hegazyy11/MCT231_Final_Project/Docs/AMONG US BASICS PRESENT FINAL.pptx

AIN SHAMS UNIVERSITY · MECHATRONICS ENGINEERING

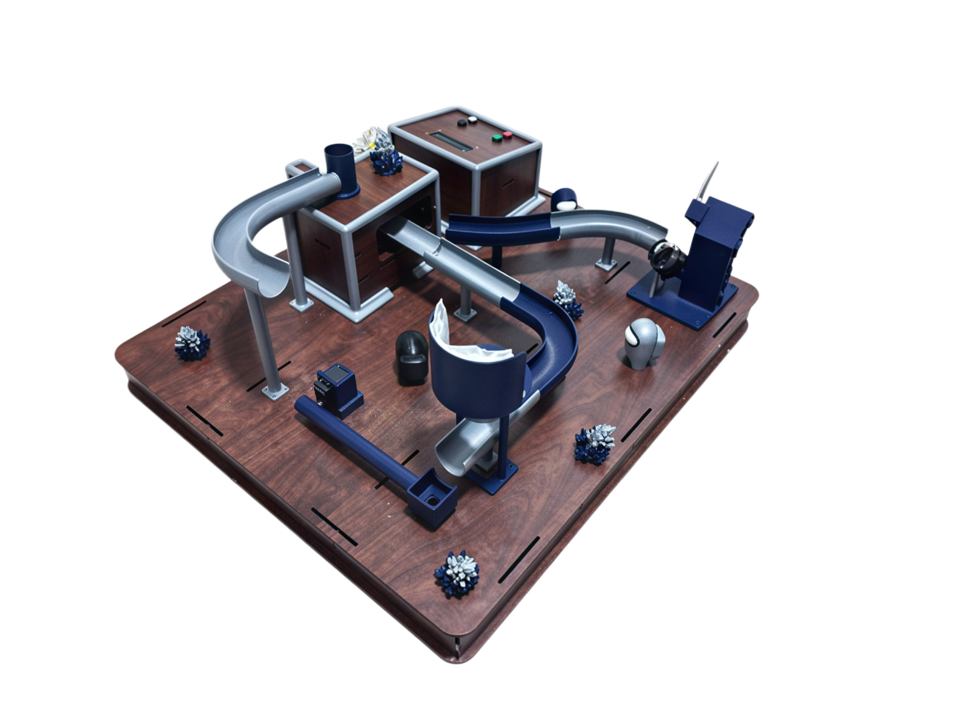
[picture p3: figure]

AMONG US

An automated closed-loop sorting, shooting & lifting toy

MCT231 — Basics of Mechatronics

Academic Year 2025 / 2026

Supervisor: Dr. Shady A. Maged

TEAM · Omar · Anas · Teefa · Essa · Mario

AMONG US

MCT231

01

## Slide 2

01 · CONTENTS

Agenda

Concept & Game

Theme, story, play loop

System Overview

The closed-loop flow

Design & Build

CAD and real prototype

Mechanisms

Sorting · Shooting · Lifting

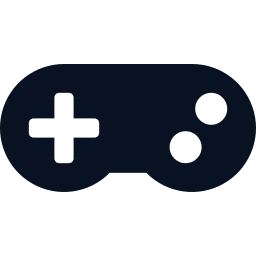
[picture p4: figure]
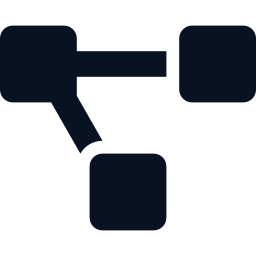
[picture p5: figure]
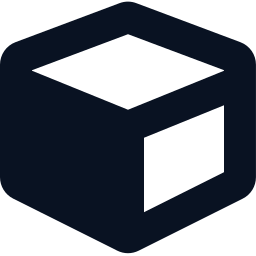
[picture p6: figure]
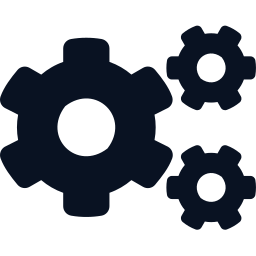
[picture p7: figure]

Electronics

Power, control & comms

Application

App & Bluetooth link

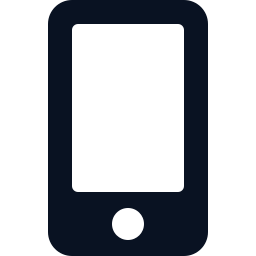
[picture p8: figure]

Problems Solved

Iteration & safety

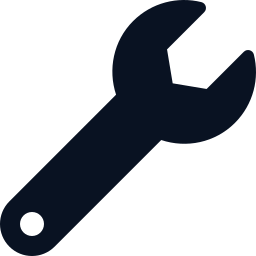
[picture p9: figure]

Results

Validation & outcomes

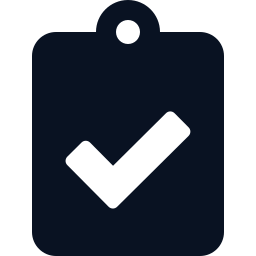
[picture p10: figure]

AMONG US

MCT231

01

## Slide 3

02 · OVERVIEW

Project Overview

An electromechanical toy for children aged 2–10 that demonstrates an automated sort–transport–dispatch cycle as a continuous physical closed loop, with a companion app for play.

KEY SPECIFICATIONS

HC-05 Bluetooth

Controllers

Inter-MCU link

Mega 2560 + Uno R3

UART · 9600 baud

Three mechanisms

Colour sorting, projectile shooting, vertical lifting.

Interfaces

I2C LCD + Processing app

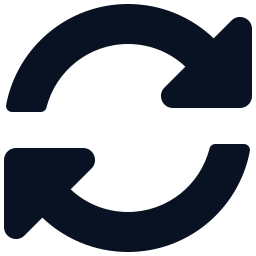
[picture p11: figure]

Closed loop

Single marble inlet; no manual reloading during play.

Wireless

Power

Single SMPS 220 V→12 V

Game

120 s timer · lives · penalties

Two microcontrollers

Arduino Mega (master) + Uno (slave) over UART.

AMONG US

MCT231

02

## Slide 4

03 · CONCEPT

Theme & Story

Reactor defusal

Inspired by the cooperative game Among Us, the player stabilises a sabotaged lunar reactor by filtering pure fuel cells (white & black balls) from corrupted ones before the countdown expires. A correct cell advances the sequence; a wrong cell costs a life and adds a time penalty.

VISUAL IDENTITY

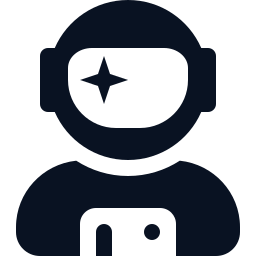
[picture p12: figure]

Navy

Lunar grey

Cyan

Red

AMONG US

MCT231

03

## Slide 5

04 · GAMEPLAY

How It Plays

Generate

App creates a colour code & starts a 120 s timer

1

Input

Player enters the code on the control panel

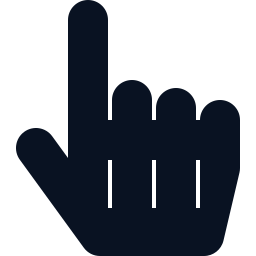
[picture p13: figure]

2

Sort

IR sensor reads each ball at the inlet

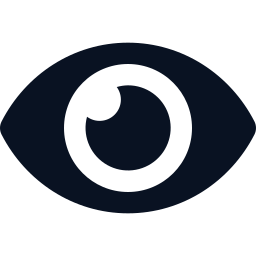
[picture p14: figure]

3

Act

Match → shoot; mismatch → reject & retry

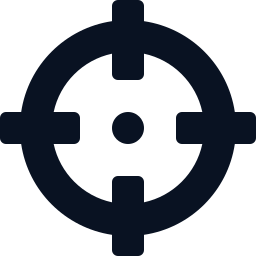
[picture p15: figure]

4

Loop

Lift returns every ball to the start

5

Correct sorting advances the defusal · incorrect sorting deducts a life + time penalty

AMONG US

MCT231

04

## Slide 6

05 · ARCHITECTURE

The Closed Loop

RE-ENTER LOOP — continuous, no manual reload

SORT

IR colour read

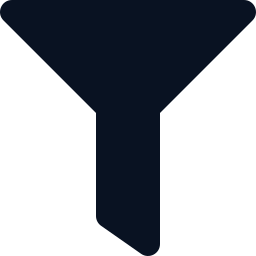
[picture p16: figure]

MATCH

SHOOT

DC motor fires
into funnel

LIFT

Servo returns
ball to start

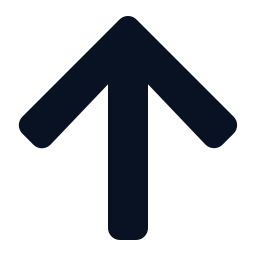
[picture p17: figure]

MISMATCH

RETURN PATH · bypasses shooter

AMONG US

MCT231

05

## Slide 7

06 · DESIGN

CAD Design

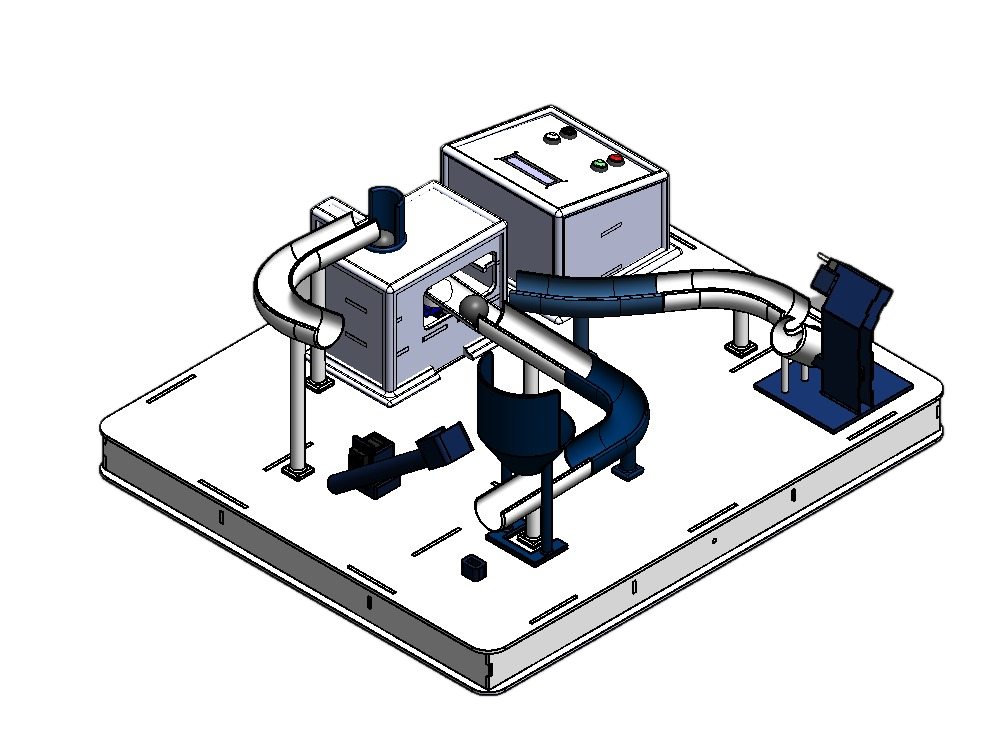
[picture p18: figure]

Fully integrated assembly

Designed in CAD; laser-cut MDF chassis with 3D-printed marble tracks and funnels.

AMONG US

MCT231

06

## Slide 8

07 · DESIGN

The Real Prototype

AMONG US

MCT231

07

## Slide 9

08 · MECHANISMS

Sorting Mechanism

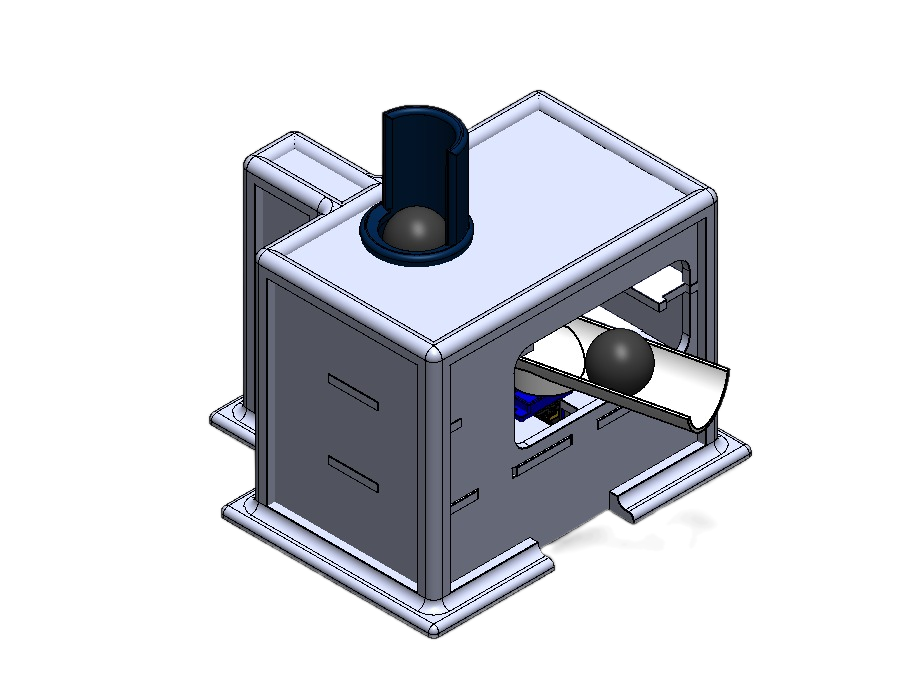
[picture p19: figure]

Entry point of the loop. A presence IR detects the ball; the colour IR reads white vs black; servos route and release the ball.

Holder servo

Home 180° → Reach 90°

Path servo

Home 105° / Shooter 142° / Return 97°

Colour sensor

Emitter power-gated per read

AMONG US

MCT231

08

## Slide 10

09 · MECHANISMS

Shooting Mechanism

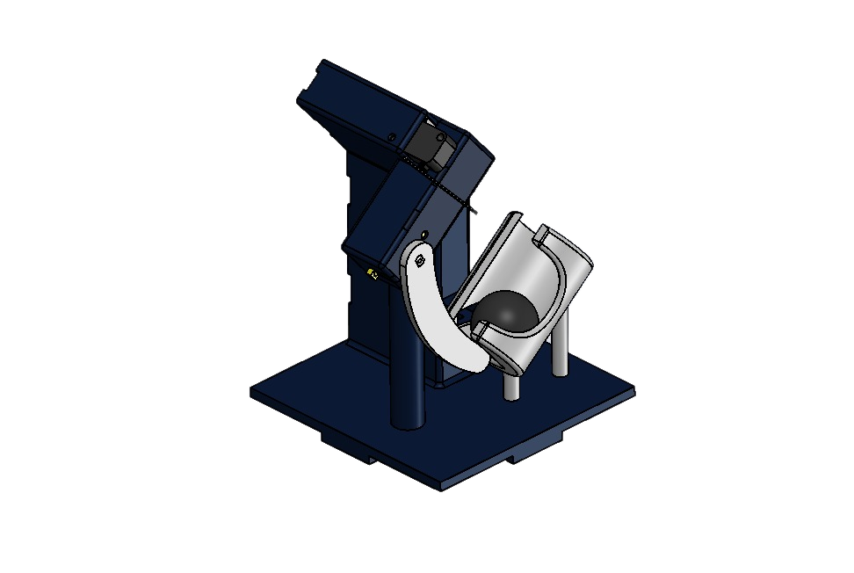
[picture p20: figure]

On a match the ball rolls to the barrel; a DC motor driven by an L298N fires it into the funnel, then retracts to a limit switch to re-home.

Driver

L298N H-bridge (PWM)

Fire / retract

PWM 90 / 35 of 255

Target range

≈ 30 cm @ 45° launch

AMONG US

MCT231

09

## Slide 11

10 · MECHANISMS

Lifting Mechanism

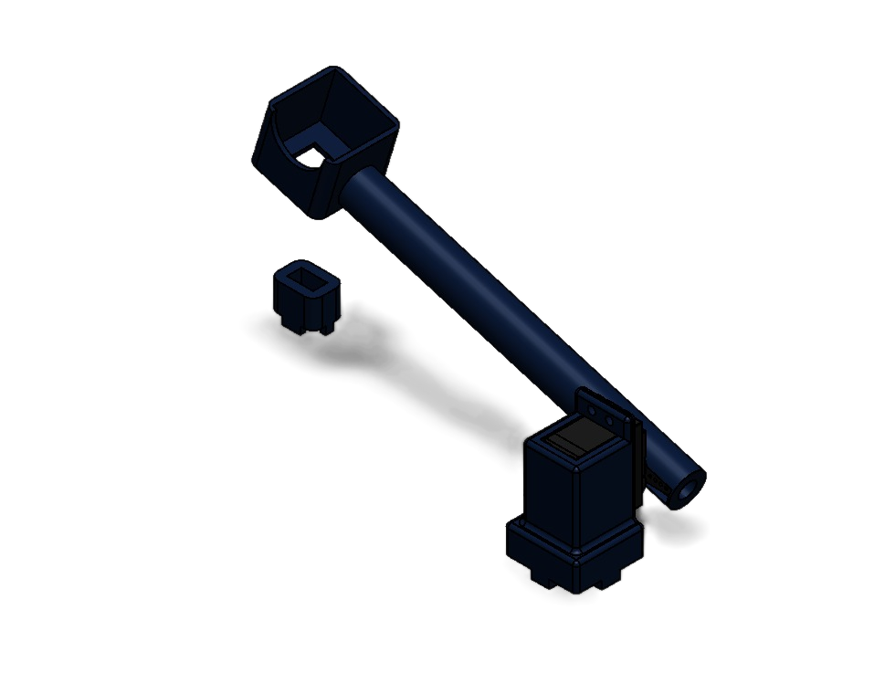
[picture p21: figure]

Common return stage for both branches. A lift IR detects the ball; the lift servo raises it and returns it to the sorting stage, closing the loop.

Lift servo

Rest 0° → Lift 95°

Detection

IR at elevator base

Role

Guarantees every ball re-enters

AMONG US

MCT231

10

## Slide 12

11 · ELECTRONICS

Power Architecture

Single source · common ground · hidden wiring

12 V BUS

SMPS

220 V AC → 12 V DC

L298N → DC motor

Shooter at 12 V

Buck converter → servos

Stepped-down servo rail

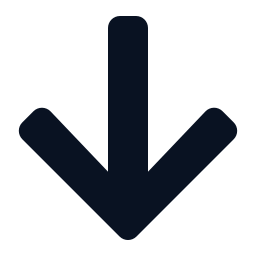
[picture p22: figure]

9 V regulator → Uno

Logic supply (VIN)

Two custom shield-PCBs (Uno + Mega) seat the boards on pin headers — no breadboards. Exceeds the ≥ 1 PCB requirement.

AMONG US

MCT231

11

## Slide 13

12 · ELECTRONICS

Control & Communication

Arduino Mega · MASTER

UI, game logic, verification & comms
LCD · 4 buttons · HC-05 · BT-state pin

MESSAGE PROTOCOL

Arduino Uno · SLAVE

Sensing & actuation
5× IR · 3× servo · L298N + DC motor · limit switch

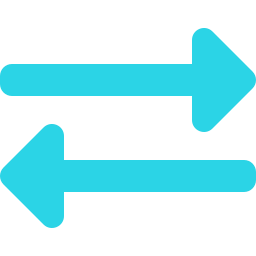
[picture p23: figure]

UART · 9600

Mega → Uno

“WBW…”

Player sequence

Built-in safety

Bluetooth-disconnect failsafe, remote app reset, and a reset routine that stops the motor, homes all servos, and clears the active sequence.

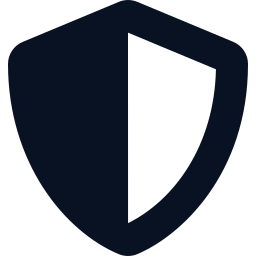
[picture p24: figure]

Mega → Uno

“R”

Reset

Uno → Mega

App → Mega

“D”

“W” / “B”

Tasks complete

Target code

Mega → App

“C” / “W”

Result

AMONG US

MCT231

12

## Slide 14

13 · INTERFACE

Mobile App & Bluetooth

App screens: code, countdown, lives, result

SCREENSHOT

Companion app

Generates the colour sequence, runs the 120 s countdown, tracks lives & penalties.

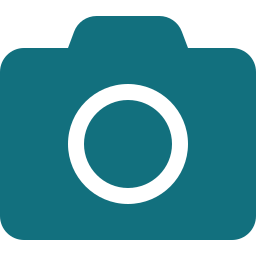
[picture p25: figure]

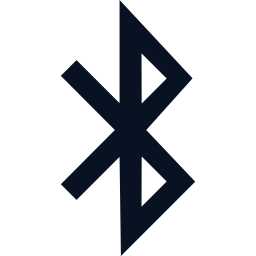
[picture p26: figure]

HC-05 link

Wireless serial pairing to the Mega for real-time, responsive control.

Second interface

Pairs with the on-board LCD to present two distinct information sets.

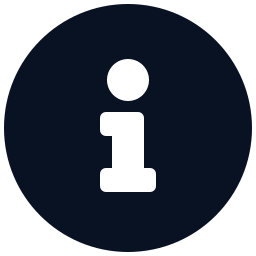
[picture p27: figure]

Status: simulation-tested — final HC-05 pairing & serial integration in progress

AMONG US

MCT231

13

## Slide 15

14 · ANALYSIS

Engineering Rigor

Every actuator is sized with the same chain: trapezoidal profile → inertia → phase torques → RMS → safety factor (1.5).

1.84

m/s launch speed

CORE FORMULAS

30

cm projectile range

1.5

safety factor (SF)

4.189

rad/s servo ωₘₐₓ

v = √(vₓ² + v_y²) v_y = √(2·g·ΔH) t_f = (v_y + √(v_y² + 2·g·y₀)) / g

J = ⅓·m·L² (rod) + m·L² (ball) T = J·α + g·(m·L/2 + m·L) T_rms = √(Σ Tᵢ²·tᵢ / t)

DC motor (L298N): I = T / K_t V = I·Rₐ + K_e·ω PWM = round((V/12)·255)

AMONG US

MCT231

14

## Slide 16

15 · ITERATION

Problem → Solution

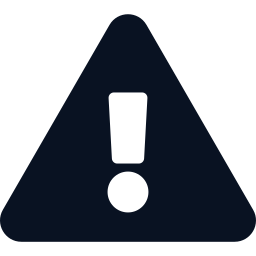
[picture p28: figure]

Sharp MDF edges

Laser-cut MDF leaves hard, sharp edges — unacceptable for a toy aimed at children aged 2–10.

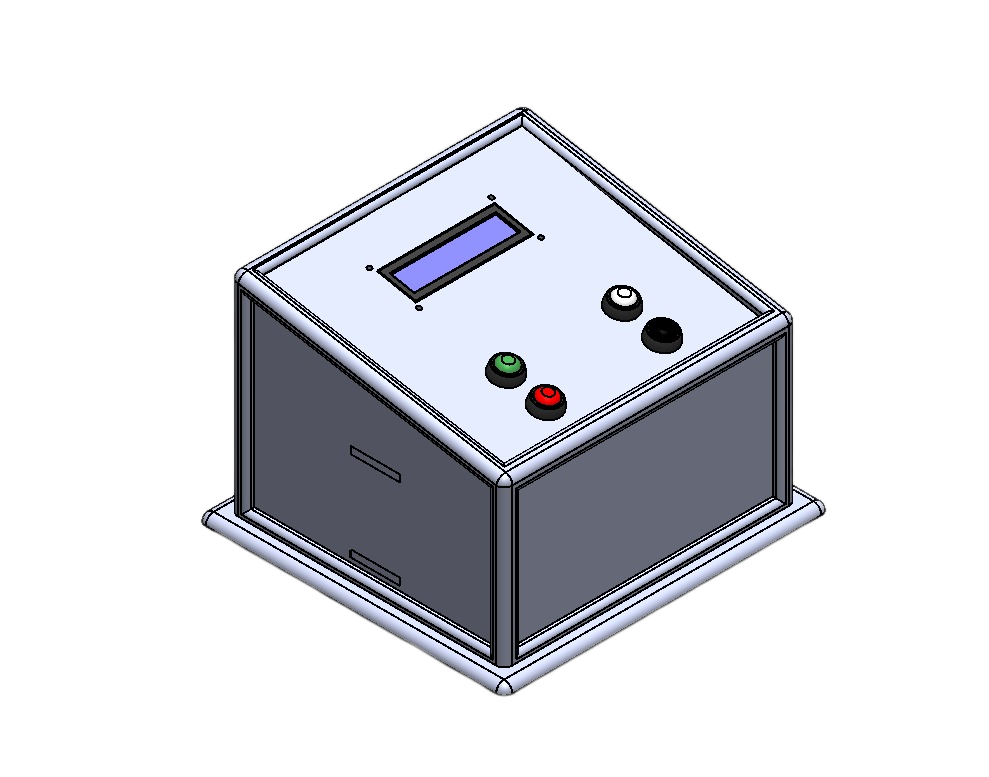
[picture p29: figure]

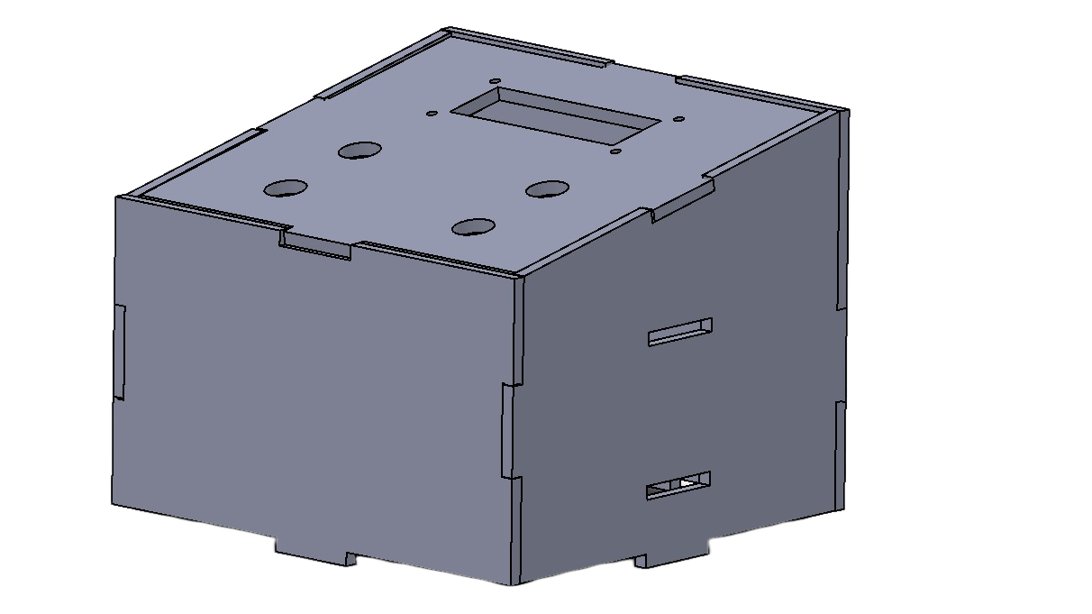
[picture p30: figure]

BEFORE

AFTER

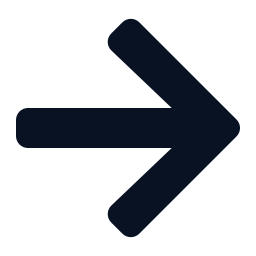
[picture p31: figure]

SOLUTION · 3D-printed edge covers on exposed edges only (not a full enclosure) — removes every reachable sharp edge while keeping the mechanisms visible.

AMONG US

MCT231

15

## Slide 17

16 · ITERATION

More Problems Solved

Exposed wiring

Loose jumper wires on the surface

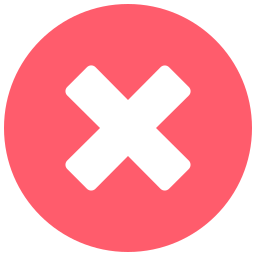
[picture p32: figure]
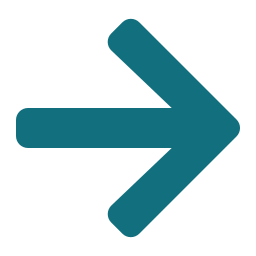
[picture p33: figure]
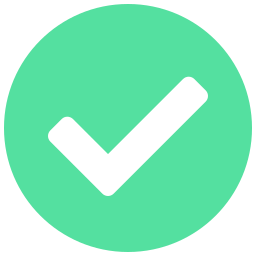
[picture p34: figure]

Routed below deck + shield-PCBs; nothing reachable

Unreliable colour read

Stray light skewed white/black detection

Power-gated emitter + calibrated threshold

AMONG US

MCT231

16

## Slide 18

17 · COMPLIANCE

Safety Considerations

No sharp edges

3D-printed covers on all exposed MDF edges

Hidden wiring

Harness below deck; no accessible contacts

Guarded motion

Moving parts shielded; choking review on balls

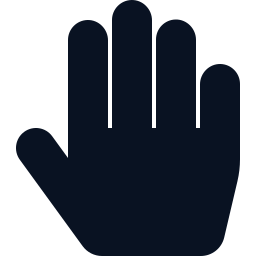
[picture p35: figure]

Single source

One SMPS, common ground, no exposed mains

Stop control

Physical start/stop + software reset

Standards intent

Aligned with CE / EN 71 toy safety

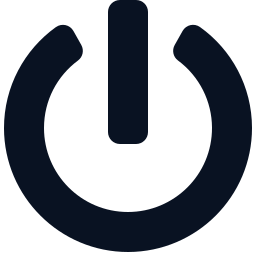
[picture p36: figure]

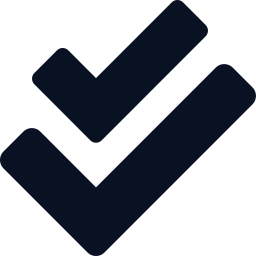
[picture p37: figure]

AMONG US

MCT231

17

## Slide 19

18 · EXECUTION

Project Management

TEAM & ROLES

Anas

CAD design

12-WEEK TIMELINE

Documentation

A

Omar

Coding + CAD design

Mechanical / CAD

O

Firmware

T

Teefa

App, comms & code integration

App / Bluetooth

E

Essa

PCB, wiring, PDS, block diagram

PCB / Electrical

M

Mario

Calculations + documentation

Integration

W1–W12 · critical path: CAD → Firmware → PCB → Integration

AMONG US

MCT231

18

## Slide 20

19 · OUTCOMES

Results & Assurance

≥ 95%

sorting accuracy target

< 200 ms

actuator response

50+

closed-loop cycles, no jam

0

dropped UART messages

VALIDATION · meets the goal

- Correct cells advance; wrong cells rejected
- App, LCD, lives & timer mirror the machine
- Safe & engaging for ages 2–10

VERIFICATION · meets the spec

- Servo set-points hit; PWM fire/retract verified
- UART 9600 baud, zero dropped messages
- Edge covers inspected; rails < 5% droop

AMONG US

MCT231

19

## Slide 21

20 · HARDWARE

Core Components

Arduino Mega 2560

Master controller

Arduino Uno R3

Slave controller

HC-05

Bluetooth module

I2C 16×2 LCD

On-board display

Servo motors ×3

Holder / path / lift

DC motor + L298N

Projectile shooter

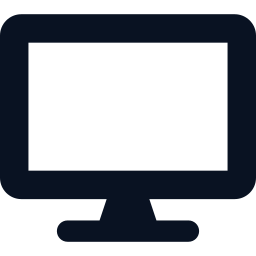
[picture p38: figure]

IR sensors ×5

Presence / colour / barrel / lift

SMPS + buck + 9 V reg

Power chain

2× shield-PCBs

Uno + Mega

AMONG US

MCT231

20

## Slide 22

21 · CLOSING

Conclusion & Next Steps

DELIVERED

- Working closed-loop toy: sort, shoot, lift
- Two-MCU master/slave over UART
- Two interfaces: LCD + Bluetooth app
- Two custom shield-PCBs, single SMPS
- Child-safe finish via 3D-printed edge covers

NEXT STEPS

Finish HC-05 pairing + serial in the app

Complete current-consumption measurements

Add sound effects & difficulty levels

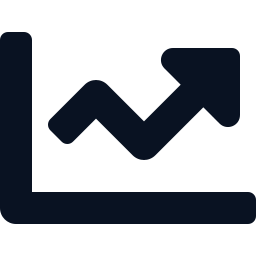
[picture p39: figure]

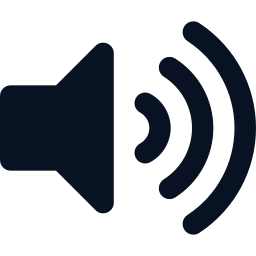
[picture p40: figure]

AMONG US

MCT231

21

## Slide 23

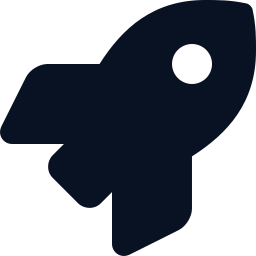
[picture p41: figure]

Thank You

Questions & discussion welcome

AMONG US · MCT231 · Omar · Anas · Teefa · Essa · Mario

AMONG US

MCT231

22
