hegazyy11/MCT231_Final_Project/Mechanical/Electric Box/Electric_Box.SLDASM

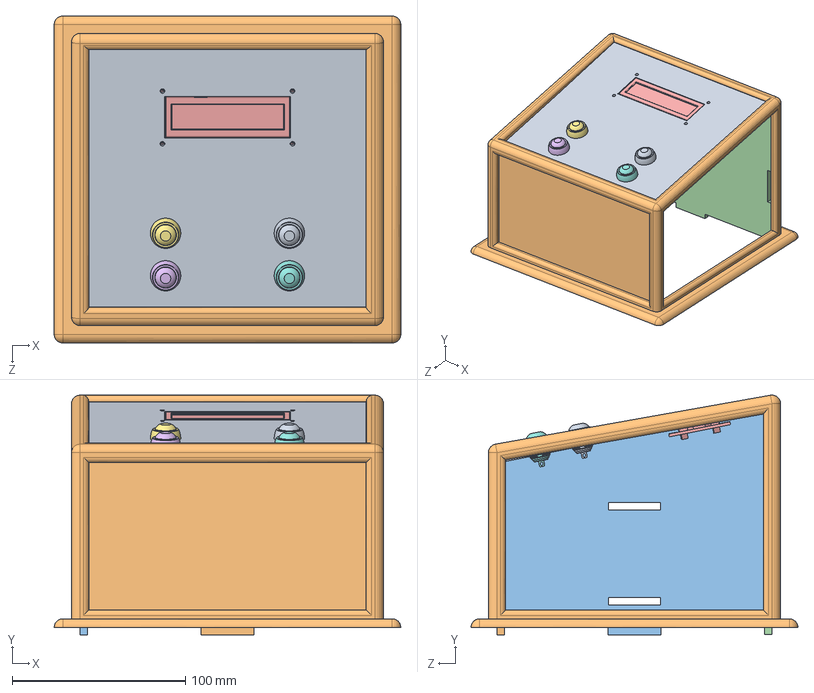
[picture p63: CAD file, 2026-06-11]
Mechanical/Electric Box/Electric_Box.SLDASM
200.0 x 138.3 x 188.6 mm
Elec_Back
Elec_Side
Elec_Front
Elec_Seiling
LCD_1602
ic184-thread_red
ic184-thread
ic184-thread_black
ic184-thread_white
box coverrrrrrr
