hegazyy11/MCT231_Final_Project/Mechanical/Project.SLDASM

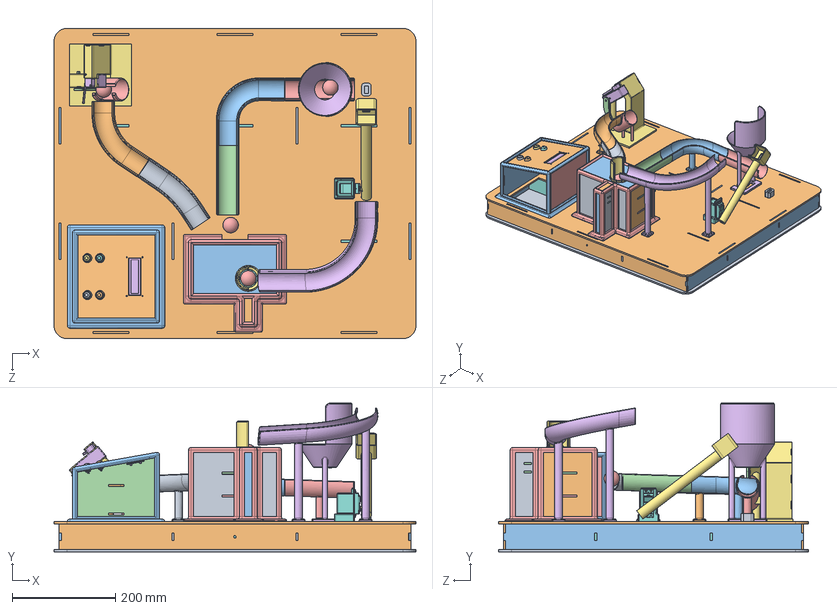
[picture p64: CAD file, 2026-06-11]
Mechanical/Project.SLDASM
700.0 x 287.9 x 600.0 mm
Short Side x 2
Long Side x 2
Middle Support (Short) x 2
Middle Support (Long) x 2
Motor Hub
Motor Hub Cover
tt motor
Shooting slide
Ball x 5
DC Arm
SWITCH LIMIT 30x16x10
Shooting wiring route cover
Upper Base
IR Hub
Motor Pillar2
Arm
attachmentStraight
servoMotorMG996R
Shooting_To_Lifting_Cone
Sorting_To_Lifting_Slide_3
Sorting_To_Lifting_Slide_1
Sorting_To_Lifting_Slide_2
Sorting_To_Shooting_Slide_2
Sorting_To_Shooting_Slide_1
Back Wall
Left Wall
Seiling
Second Floor
Upper Curve
First Floor
[4145] TowerPro SG90 Mini Servo-SunRobotics_in-Pt3 x 2
[4145] TowerPro SG90 Mini Servo-SunRobotics_in-Pt1 x 2
Right Wall
IR Tower Side x 2
IR Tower Seiling
IR Tower Back
IR Floor x 2
Soring Cone 2
sorting covvvver
Lifting_To_Sorting_Slide
Elec_Back
Elec_Side
Elec_Front
Elec_Seiling
LCD_1602
ic184-thread_red
ic184-thread
ic184-thread_black
ic184-thread_white
box coverrrrrrr
Lower Base
sorting face
