hegazyy11/MCT231_Final_Project/Mechanical/Sorting Mechanism/Sorting Mechanism.SLDASM

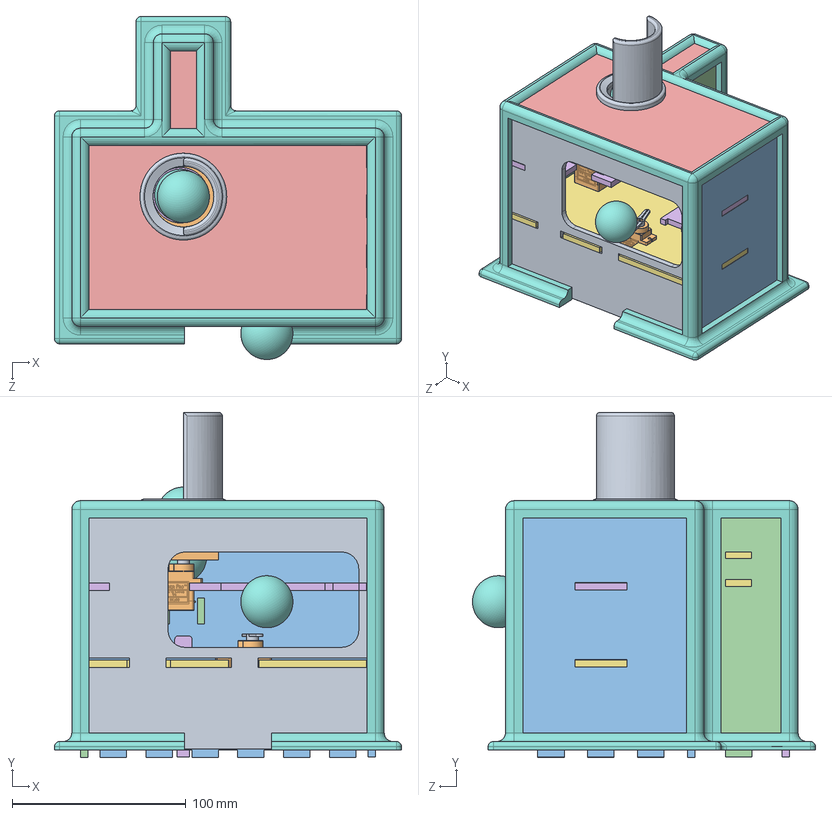
[picture p65: CAD file, 2026-06-11]
Mechanical/Sorting Mechanism/Sorting Mechanism.SLDASM
200.0 x 198.9 x 197.6 mm
Back Wall
Left Wall
Seiling
Second Floor
Upper Curve
First Floor
Ball x 3
[4145] TowerPro SG90 Mini Servo-SunRobotics_in-Pt3 x 2
[4145] TowerPro SG90 Mini Servo-SunRobotics_in-Pt1 x 2
Right Wall
IR Tower Side x 2
IR Tower Seiling
IR Tower Back
IR Floor x 2
Soring Cone 2
sorting face
