hegazyy11/MCT231_Final_Project/Mechanical/Shooting Mechanism/Motor Hub Assembly.SLDASM

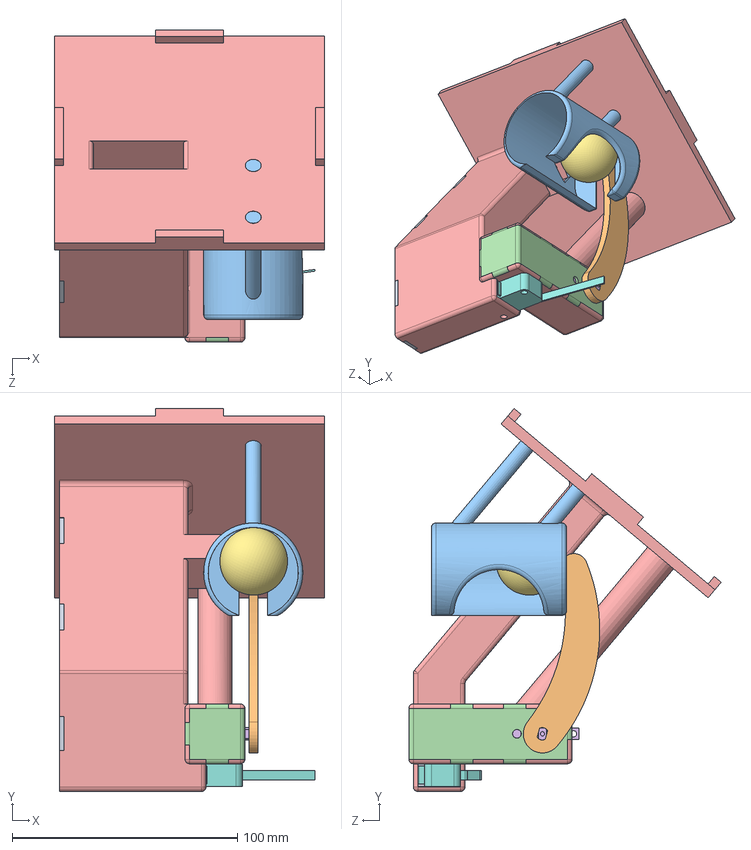
[picture p66: CAD file, 2026-06-11]
Mechanical/Shooting Mechanism/Motor Hub Assembly.SLDASM
120.0 x 170.0 x 138.7 mm
Motor Hub
Motor Hub Cover
tt motor
Shooting slide
Ball
DC Arm
SWITCH LIMIT 30x16x10
Shooting wiring route cover
