hegazyy11/MCT231_Final_Project/Mechanical/Base/Upper Base.SLDPRT

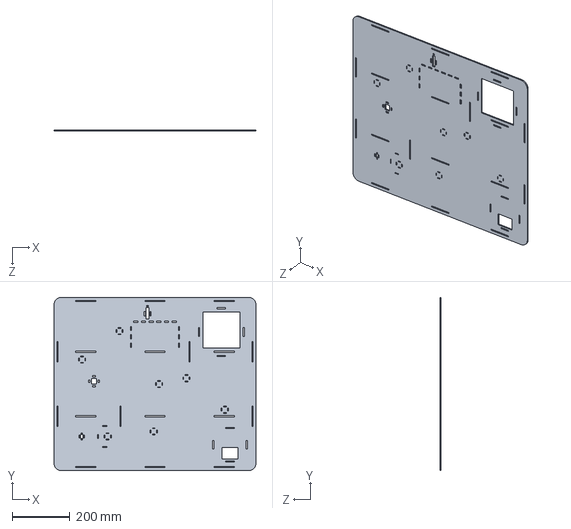
[picture p67: CAD file, 2026-06-11]
Mechanical/Base/Upper Base.SLDPRT
700.0 x 600.0 x 4.30 mm
