hegazyy11/MCT231_Final_Project/Mechanical/Lifting Mechansim/Arm.SLDPRT

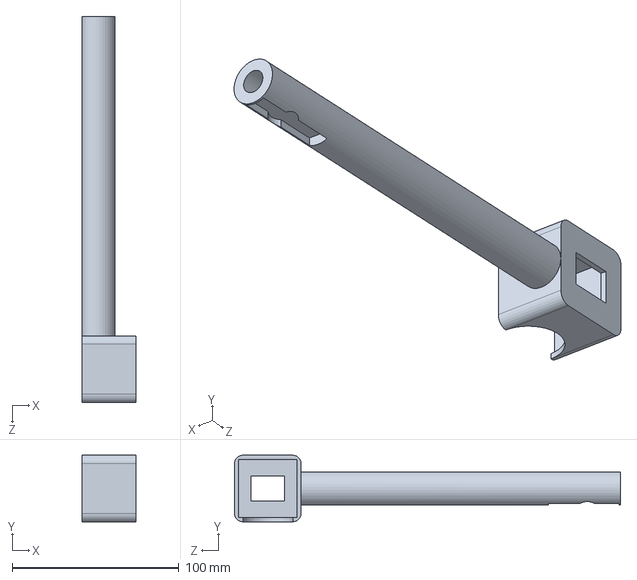
[picture p68: CAD file, 2026-06-11]
Mechanical/Lifting Mechansim/Arm.SLDPRT
32.5 x 40.0 x 231.7 mm
