hegazyy11/MCT231_Final_Project/Mechanical/Routing/Lifting_To_Sorting_Slide.SLDPRT

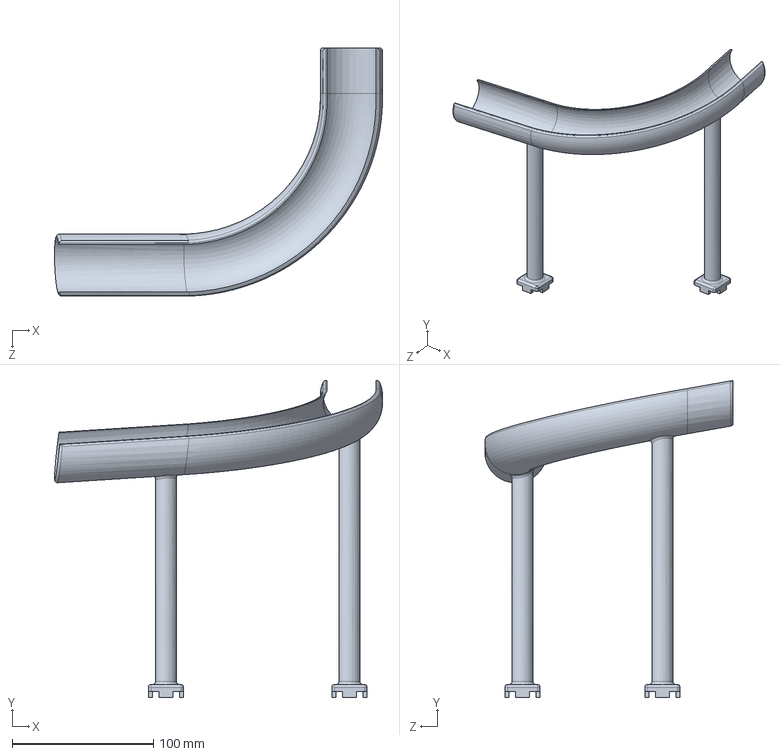
[picture p69: CAD file, 2026-06-11]
Mechanical/Routing/Lifting_To_Sorting_Slide.SLDPRT
232.0 x 224.3 x 175.6 mm
