hegazyy11/MCT231_Final_Project/Mechanical/Shooting Mechanism/Shooting wiring route cover.SLDPRT

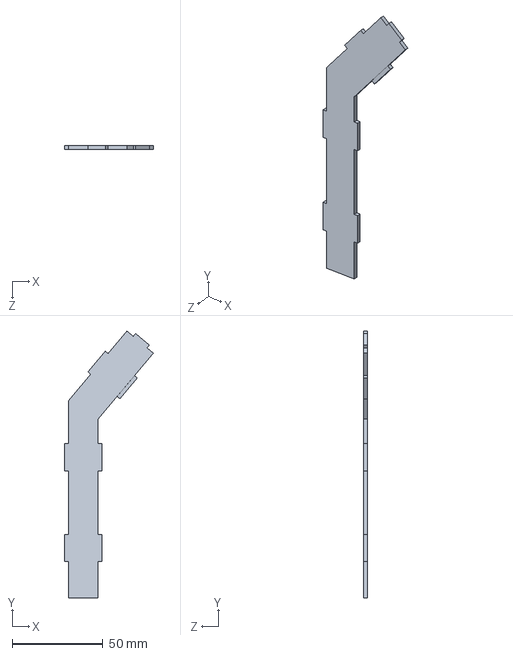
[picture p70: CAD file, 2026-06-11]
Mechanical/Shooting Mechanism/Shooting wiring route cover.SLDPRT
48.9 x 147.0 x 2.00 mm
