hegazyy11/MCT231_Final_Project/Mechanical/Sorting Mechanism/sorting face .SLDPRT

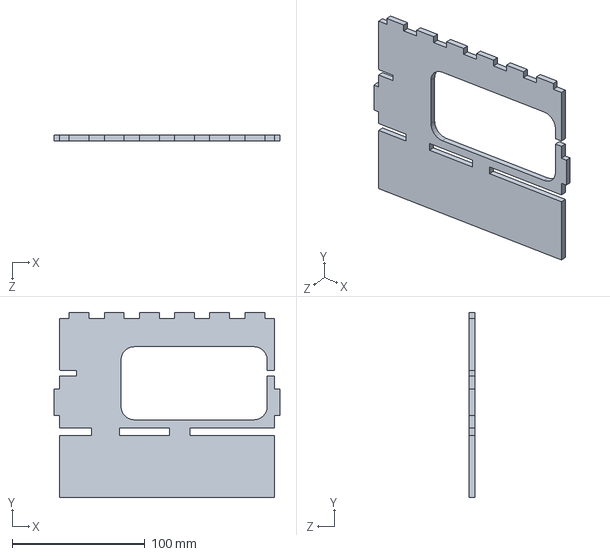
[picture p71: CAD file, 2026-06-11]
Mechanical/Sorting Mechanism/sorting face .SLDPRT
170.0 x 139.3 x 4.30 mm
