hegazyy11/MCT231_Final_Project/Mechanical/Base/Short Side.SLDPRT

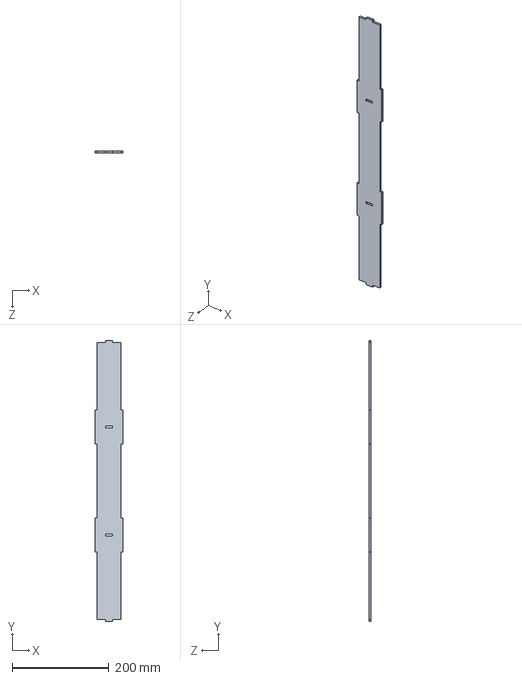
[picture p72: CAD file, 2026-06-11]
Mechanical/Base/Short Side.SLDPRT
58.6 x 580.6 x 4.30 mm
