hegazyy11/MCT231_Final_Project/Mechanical/Electric Box/LCD_1602.SLDPRT

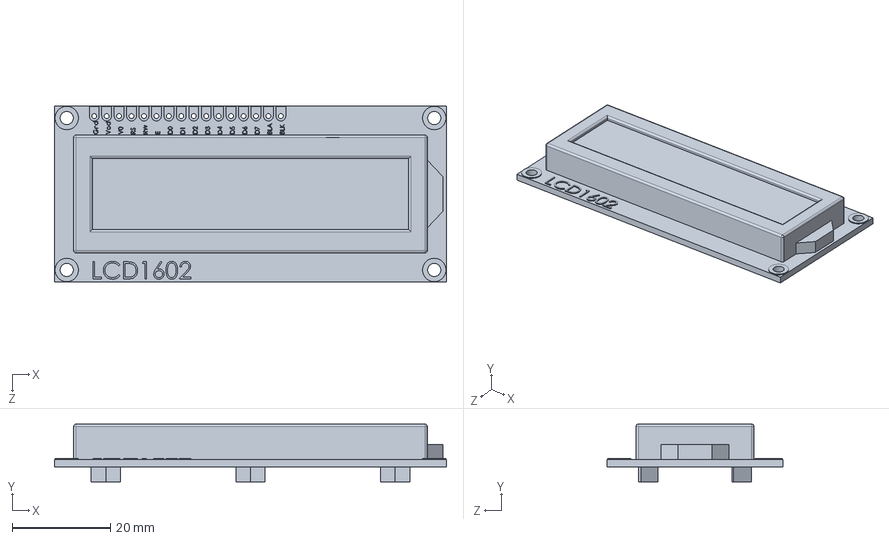
[picture p73: CAD file, 2026-06-11]
Mechanical/Electric Box/LCD_1602.SLDPRT
80.0 x 11.8 x 36.0 mm
