hegazyy11/MCT231_Final_Project/Mechanical/Lifting Mechansim/IR Hub.SLDPRT

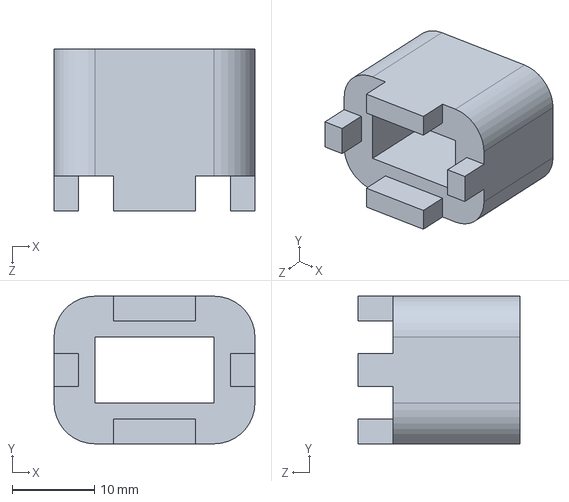
[picture p74: CAD file, 2026-06-11]
Mechanical/Lifting Mechansim/IR Hub.SLDPRT
24.5 x 18.0 x 19.8 mm
