hegazyy11/MCT231_Final_Project/Mechanical/Routing/Sorting_To_Shooting_Slide_2.SLDPRT

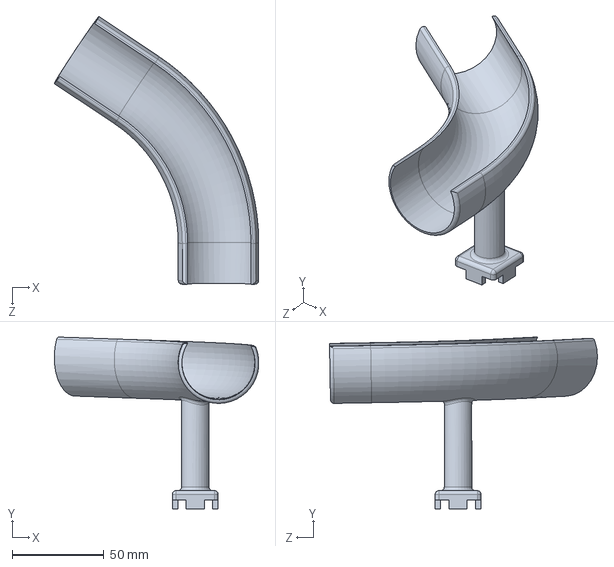
[picture p75: CAD file, 2026-06-11]
Mechanical/Routing/Sorting_To_Shooting_Slide_2.SLDPRT
111.6 x 93.8 x 146.3 mm
