hegazyy11/MCT231_Final_Project/Mechanical/Shooting Mechanism/Shooting slide.SLDPRT

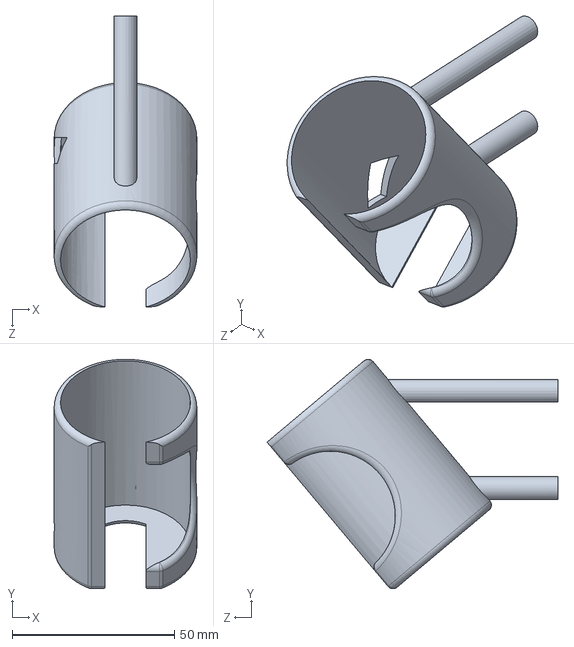
[picture p76: CAD file, 2026-06-11]
Mechanical/Shooting Mechanism/Shooting slide.SLDPRT
44.0 x 70.7 x 89.7 mm
