hegazyy11/MCT231_Final_Project/Mechanical/Base/Middle Support (Short).SLDPRT

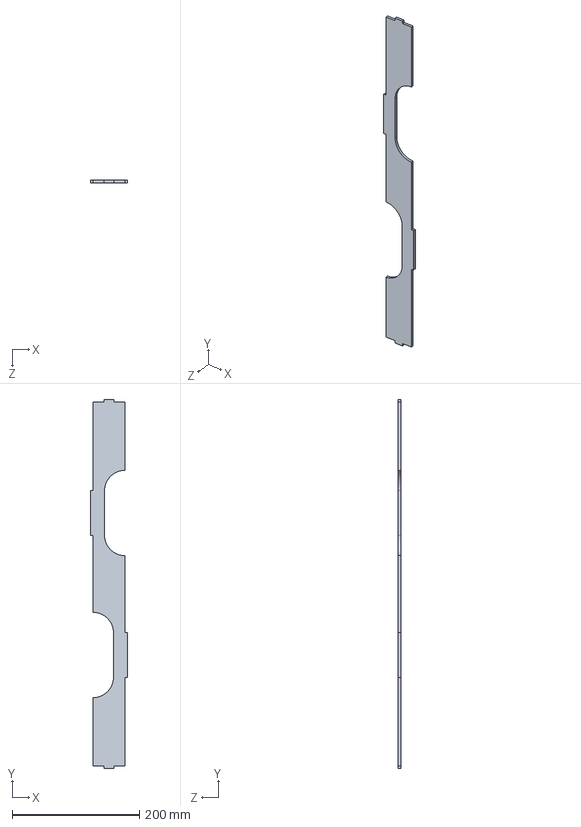
[picture p77: CAD file, 2026-06-11]
Mechanical/Base/Middle Support (Short).SLDPRT
58.6 x 580.6 x 4.30 mm
