hegazyy11/MCT231_Final_Project/Mechanical/Electric Box/ic184-thread_white.SLDPRT

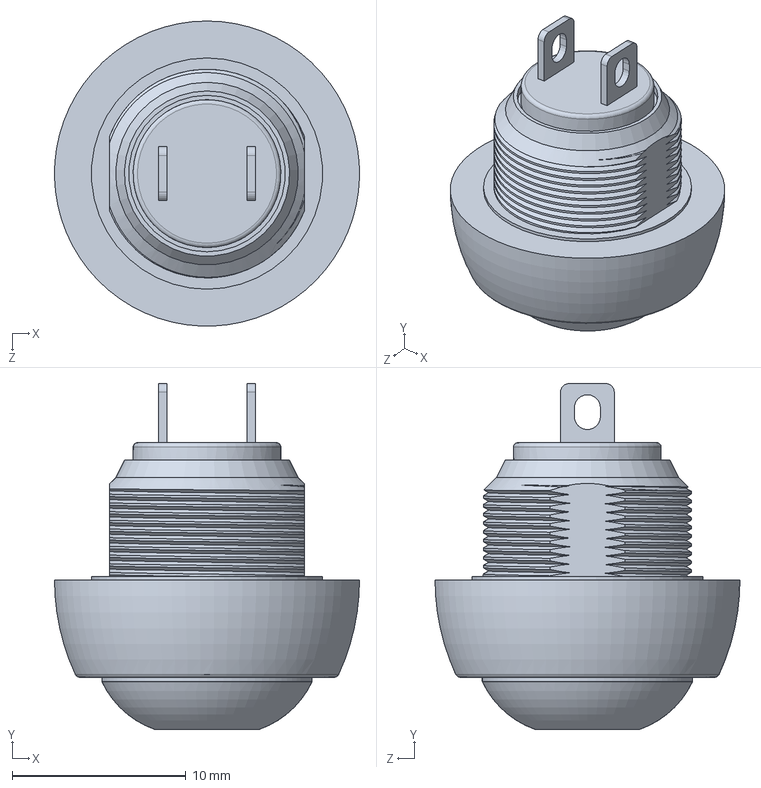
[picture p78: CAD file, 2026-06-11]
Mechanical/Electric Box/ic184-thread_white.SLDPRT
17.5 x 19.9 x 17.5 mm
