hegazyy11/MCT231_Final_Project/Mechanical/Lifting Mechansim/Motor Pillar2.SLDPRT

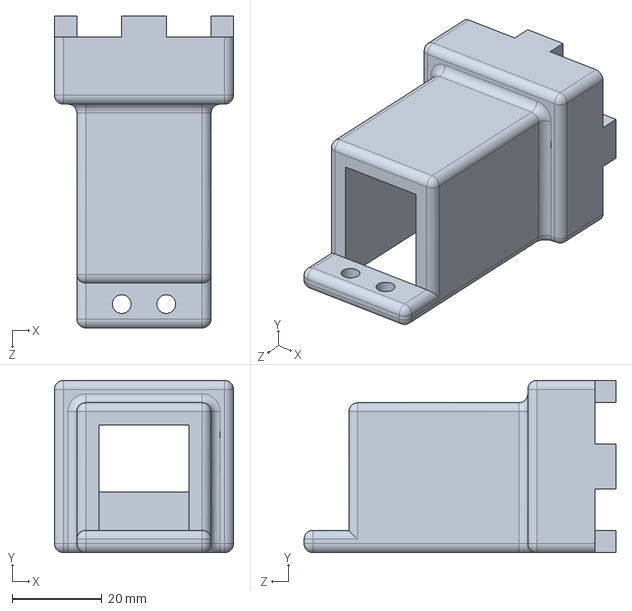
[picture p79: CAD file, 2026-06-11]
Mechanical/Lifting Mechansim/Motor Pillar2.SLDPRT
40.0 x 38.5 x 69.7 mm
