hegazyy11/MCT231_Final_Project/Mechanical/Routing/Sorting_To_Lifting_Slide_3.SLDPRT

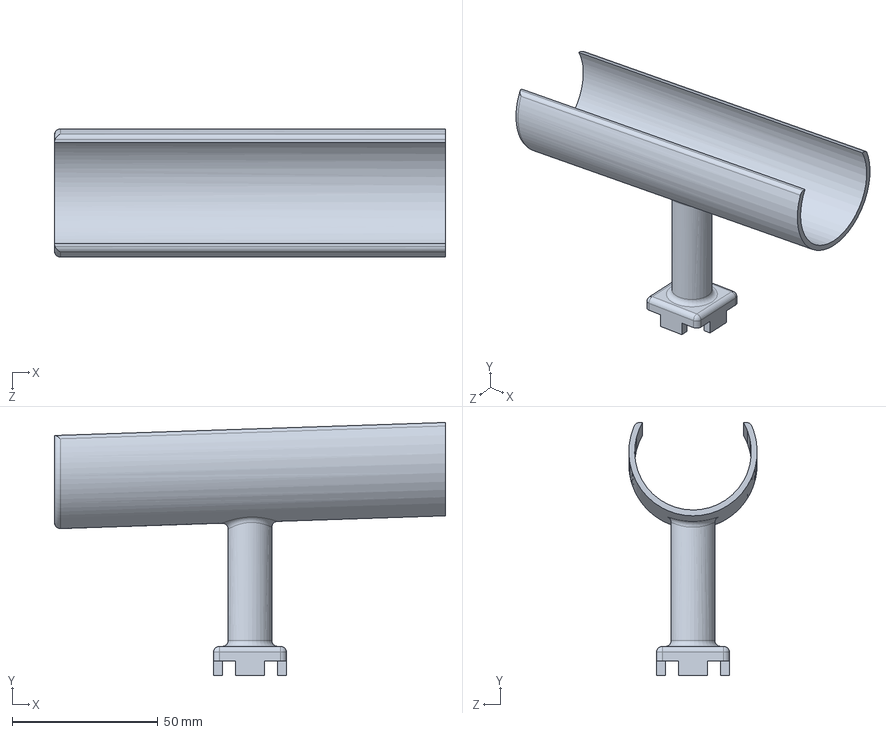
[picture p80: CAD file, 2026-06-11]
Mechanical/Routing/Sorting_To_Lifting_Slide_3.SLDPRT
134.0 x 86.7 x 44.0 mm
