hegazyy11/MCT231_Final_Project/Mechanical/Sorting Mechanism/[4145] TowerPro SG90 Mini Servo-SunRobotics_in-Pt1.SLDPRT

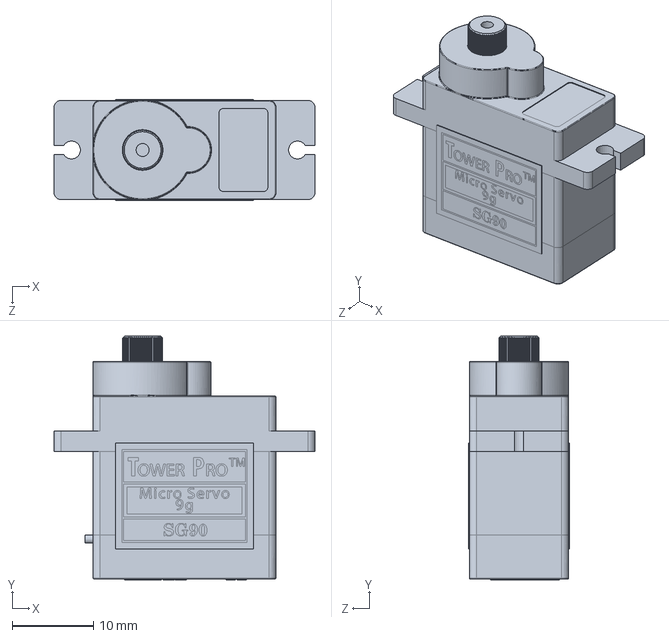
[picture p81: CAD file, 2026-06-11]
Mechanical/Sorting Mechanism/[4145] TowerPro SG90 Mini Servo-SunRobotics_in-Pt1.SLDPRT
32.1 x 30.0 x 12.4 mm
