hegazyy11/MCT231_Final_Project/Mechanical/Base/Long Side.SLDPRT

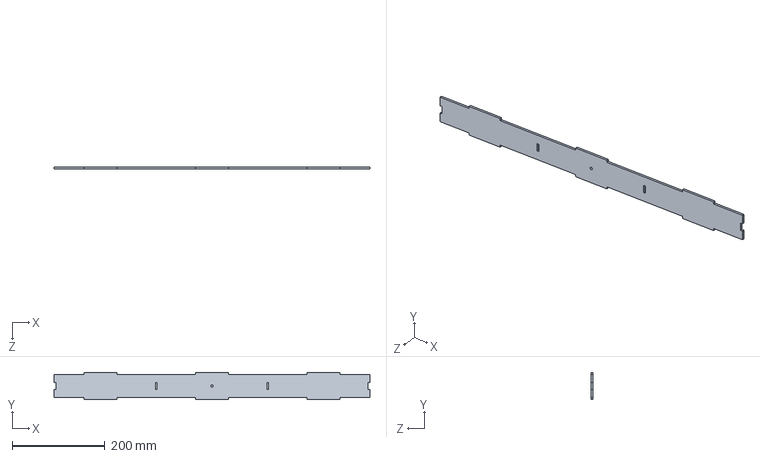
[picture p82: CAD file, 2026-06-11]
Mechanical/Base/Long Side.SLDPRT
680.0 x 58.6 x 4.30 mm
