hegazyy11/MCT231_Final_Project/Mechanical/Lifting Mechansim/servoMotorMG996R.SLDPRT

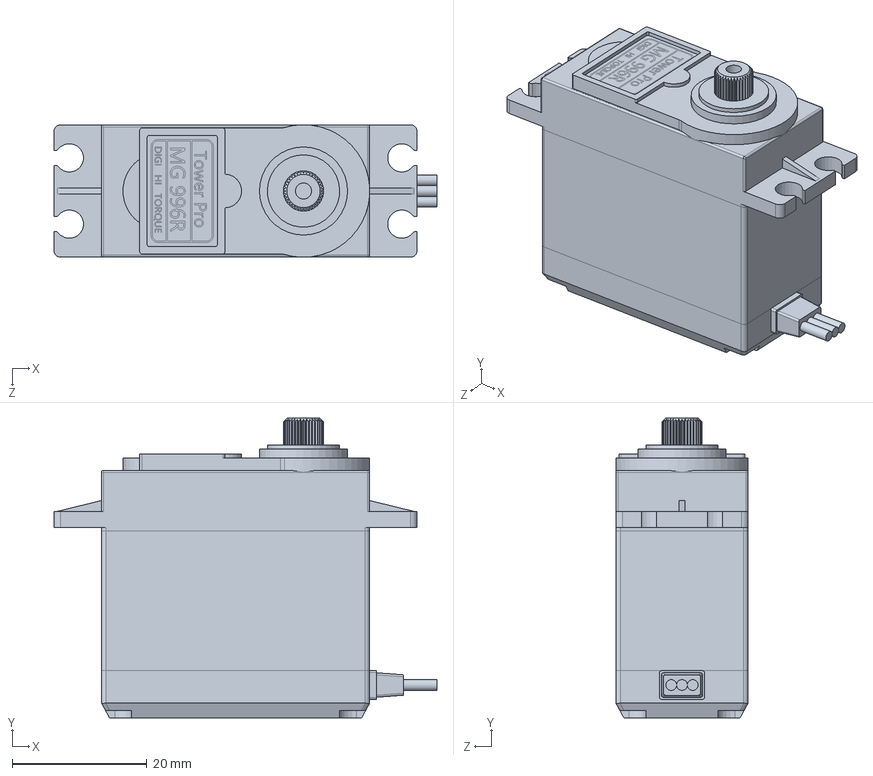
[picture p83: CAD file, 2026-06-11]
Mechanical/Lifting Mechansim/servoMotorMG996R.SLDPRT
57.0 x 44.5 x 19.7 mm
