hegazyy11/MCT231_Final_Project/Mechanical/Routing/Sorting_To_Lifting_Slide_2.SLDPRT

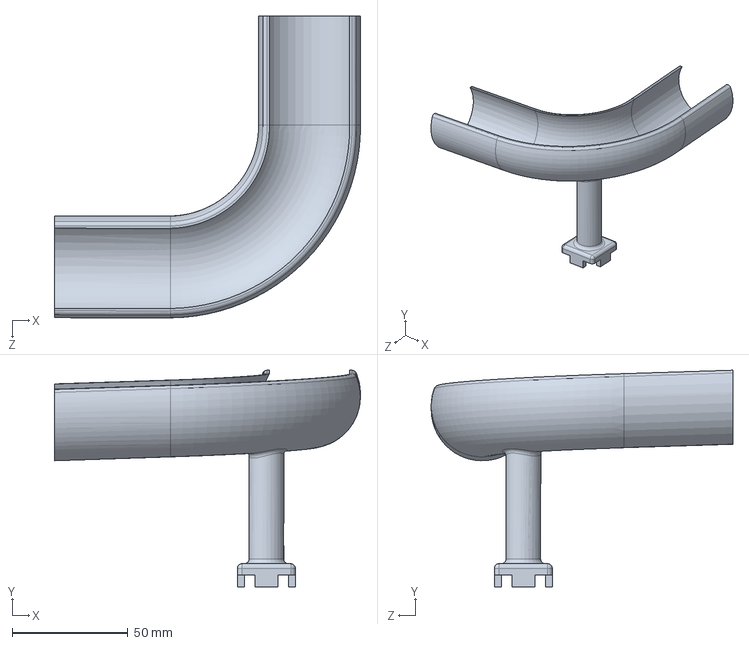
[picture p84: CAD file, 2026-06-11]
Mechanical/Routing/Sorting_To_Lifting_Slide_2.SLDPRT
132.0 x 93.4 x 130.2 mm
