hegazyy11/MCT231_Final_Project/Mechanical/Shooting Mechanism/Motor Hub Cover.SLDPRT

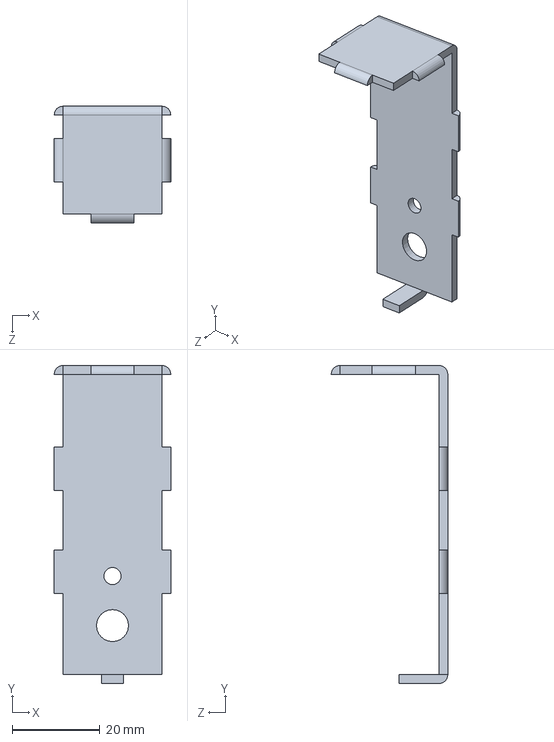
[picture p85: CAD file, 2026-06-11]
Mechanical/Shooting Mechanism/Motor Hub Cover.SLDPRT
26.6 x 72.5 x 26.6 mm
