hegazyy11/MCT231_Final_Project/Mechanical/Sorting Mechanism/Upper Curve.SLDPRT

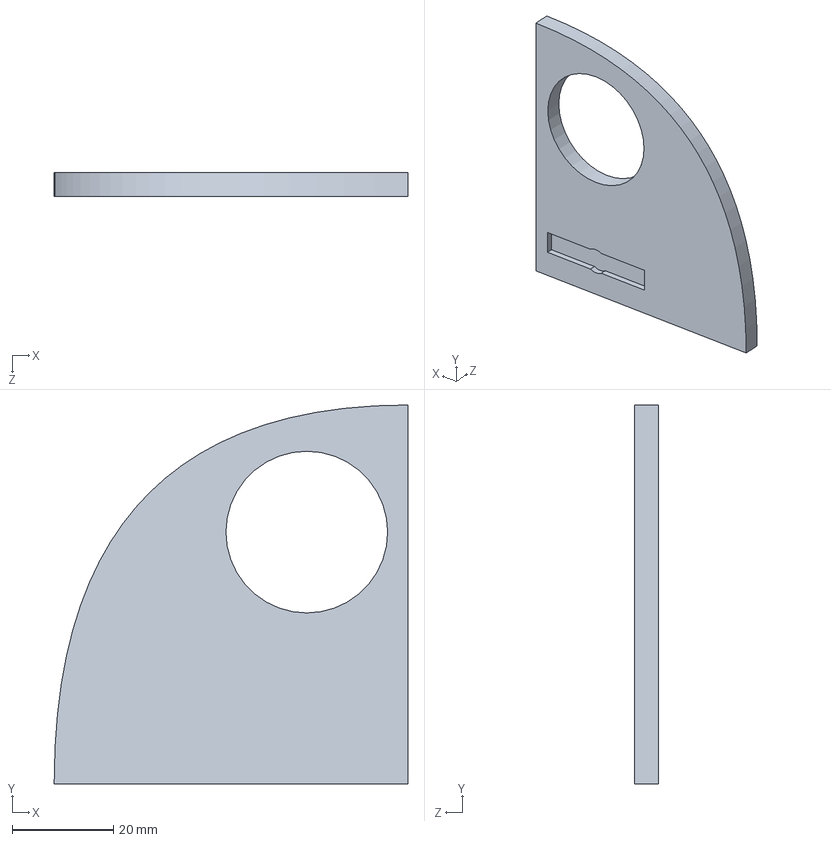
[picture p86: CAD file, 2026-06-11]
Mechanical/Sorting Mechanism/Upper Curve.SLDPRT
70.0 x 75.0 x 4.70 mm
