hegazyy11/MCT231_Final_Project/Mechanical/Base/Middle Support (Long).SLDPRT

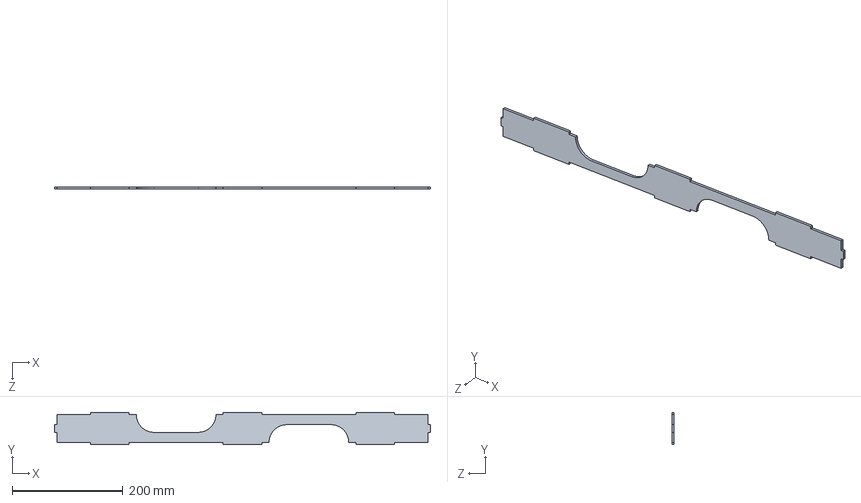
[picture p87: CAD file, 2026-06-11]
Mechanical/Base/Middle Support (Long).SLDPRT
680.0 x 58.6 x 4.30 mm
