hegazyy11/MCT231_Final_Project/Mechanical/Electric Box/Elec_Seiling.SLDPRT

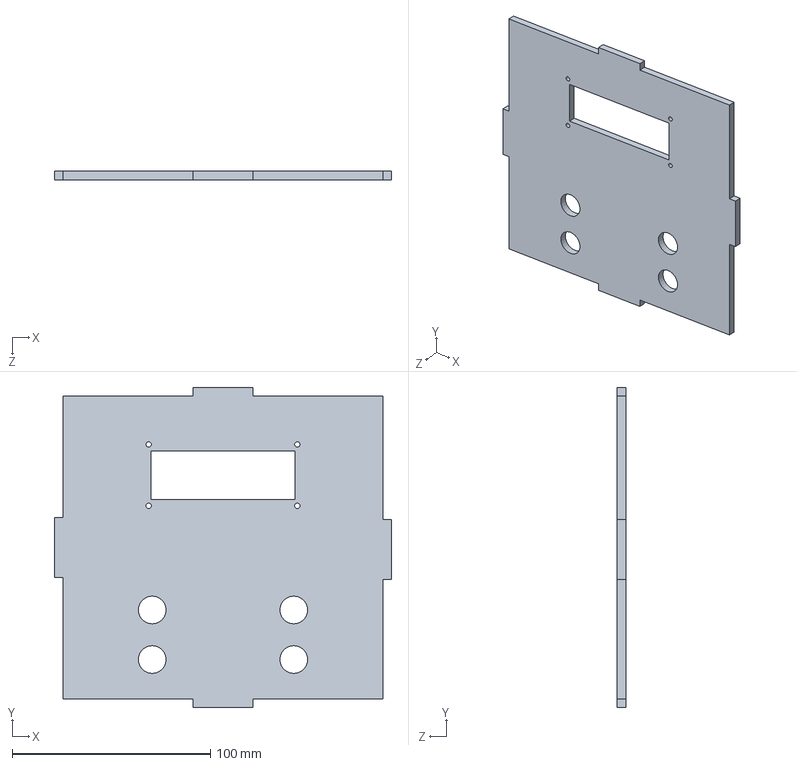
[picture p88: CAD file, 2026-06-11]
Mechanical/Electric Box/Elec_Seiling.SLDPRT
170.0 x 161.6 x 4.30 mm
