hegazyy11/MCT231_Final_Project/Mechanical/Routing/Sorting_To_Shooting_Slide_1.SLDPRT

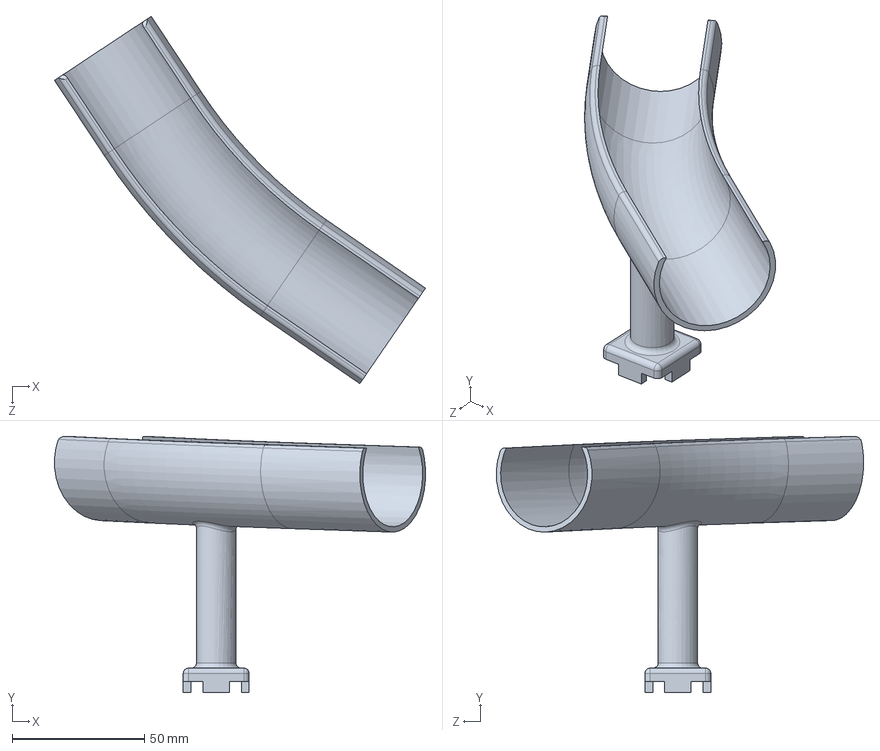
[picture p89: CAD file, 2026-06-11]
Mechanical/Routing/Sorting_To_Shooting_Slide_1.SLDPRT
140.5 x 97.1 x 139.1 mm
