hegazyy11/MCT231_Final_Project/Mechanical/Shooting Mechanism/Motor Hub.SLDPRT

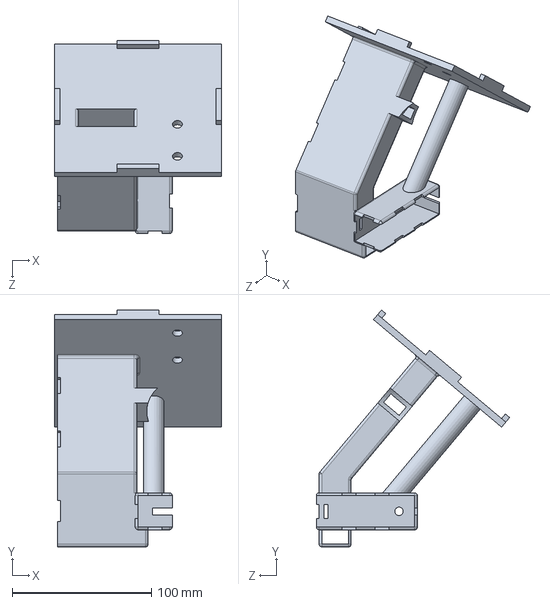
[picture p90: CAD file, 2026-06-11]
Mechanical/Shooting Mechanism/Motor Hub.SLDPRT
120.0 x 170.0 x 138.7 mm
