hegazyy11/MCT231_Final_Project/Mechanical/Sorting Mechanism/Left Wall.SLDPRT

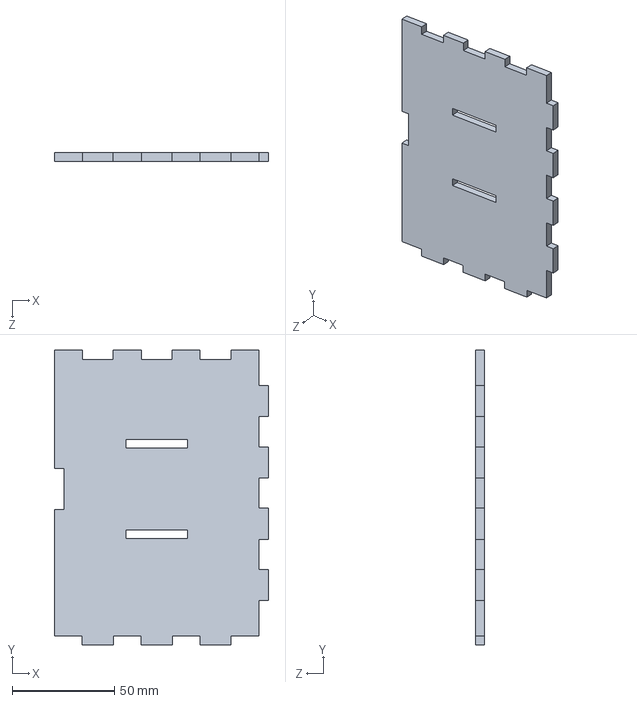
[picture p91: CAD file, 2026-06-11]
Mechanical/Sorting Mechanism/Left Wall.SLDPRT
104.7 x 144.3 x 4.30 mm
