hegazyy11/MCT231_Final_Project/Mechanical/Base/Lower Base.SLDPRT

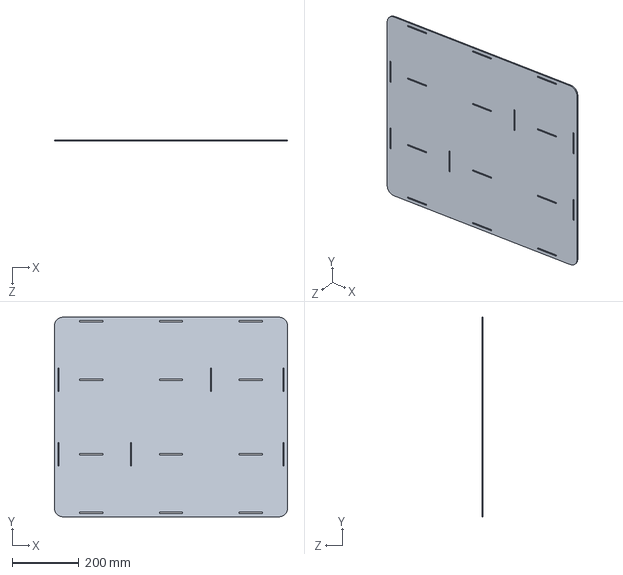
[picture p92: CAD file, 2026-06-11]
Mechanical/Base/Lower Base.SLDPRT
700.0 x 600.0 x 4.30 mm
