hegazyy11/MCT231_Final_Project/Mechanical/Routing/Shooting_To_Lifting_Cone.SLDPRT

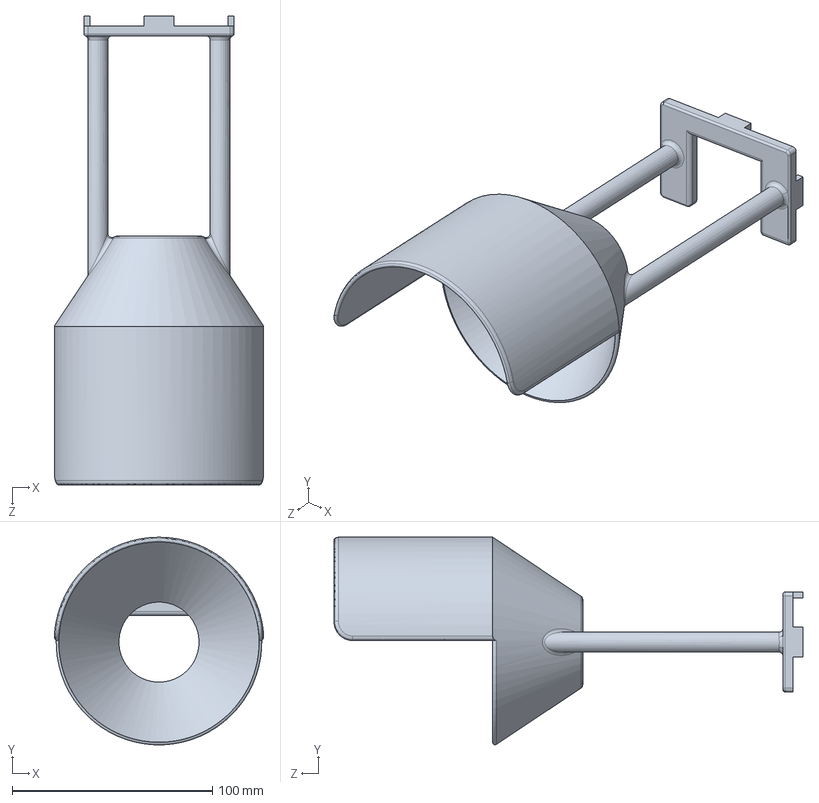
[picture p93: CAD file, 2026-06-11]
Mechanical/Routing/Shooting_To_Lifting_Cone.SLDPRT
104.6 x 103.7 x 234.3 mm
