hegazyy11/MCT231_Final_Project/Mechanical/Shooting Mechanism/tt motor.SLDPRT

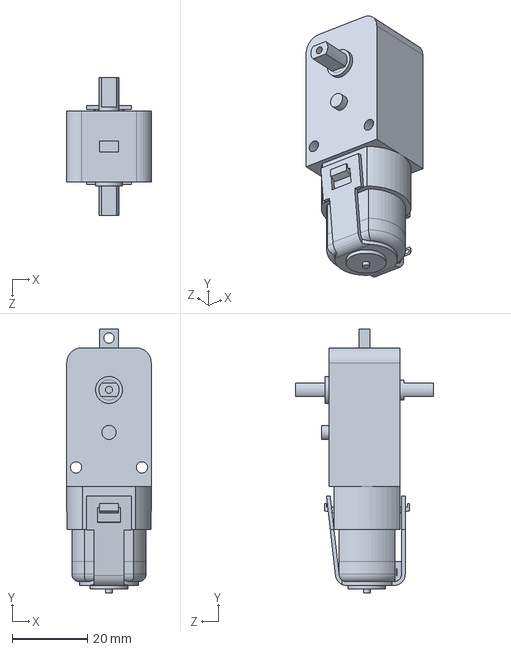
[picture p94: CAD file, 2026-06-11]
Mechanical/Shooting Mechanism/tt motor.SLDPRT
22.5 x 70.2 x 36.8 mm
