hegazyy11/MCT231_Final_Project/Mechanical/Sorting Mechanism/IR Tower Side.SLDPRT

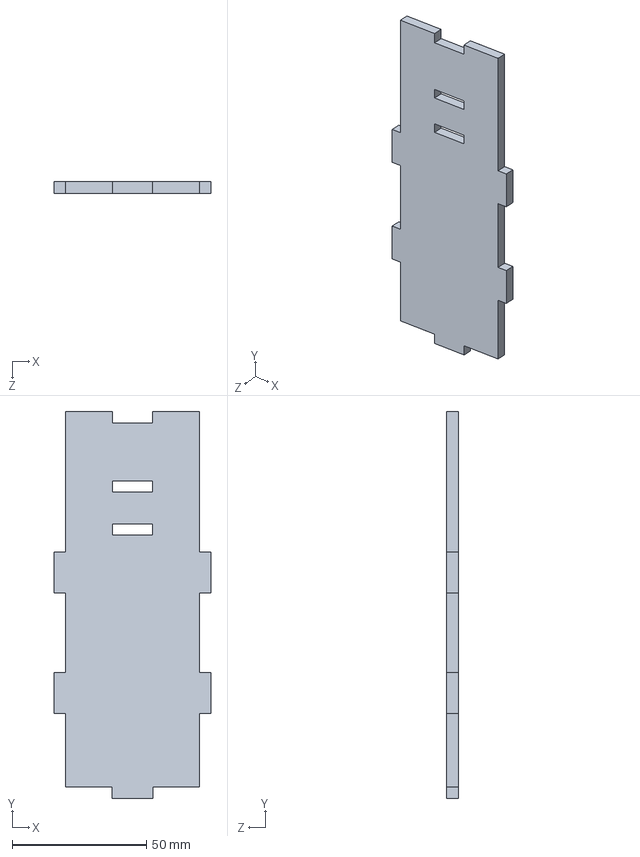
[picture p95: CAD file, 2026-06-11]
Mechanical/Sorting Mechanism/IR Tower Side.SLDPRT
58.4 x 144.3 x 4.30 mm
