hegazyy11/MCT231_Final_Project/Mechanical/Electric Box/Elec_Back.SLDPRT

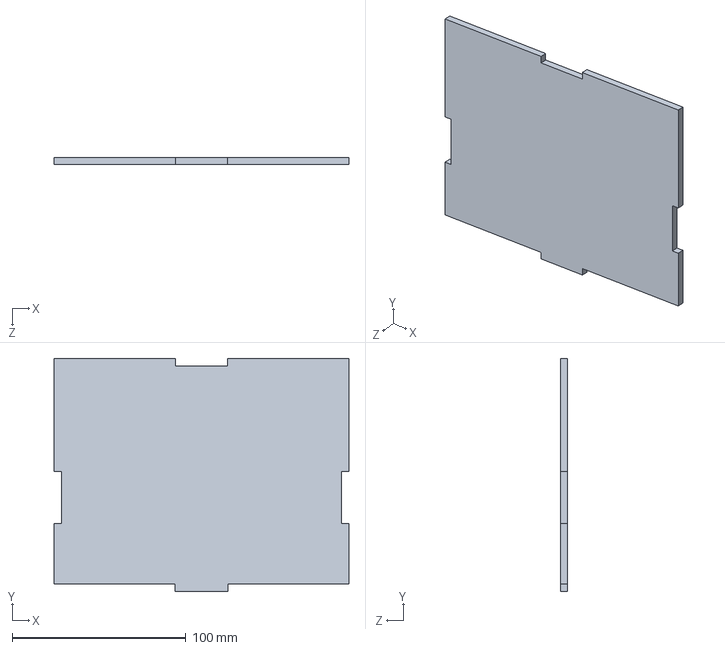
[picture p96: CAD file, 2026-06-11]
Mechanical/Electric Box/Elec_Back.SLDPRT
170.0 x 134.3 x 4.30 mm
