hegazyy11/MCT231_Final_Project/Mechanical/Routing/Soring Cone 2.SLDPRT

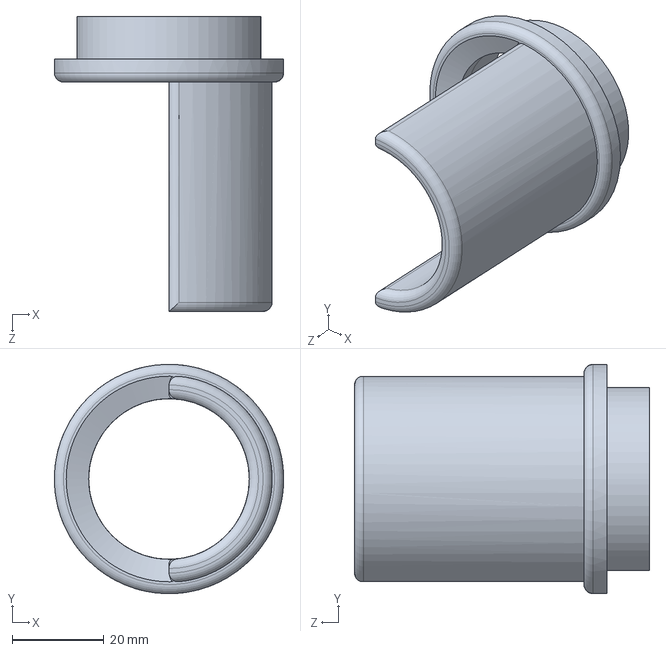
[picture p97: CAD file, 2026-06-11]
Mechanical/Routing/Soring Cone 2.SLDPRT
50.0 x 50.0 x 64.3 mm
