hegazyy11/MCT231_Final_Project/Mechanical/Shooting Mechanism/DC Arm.SLDPRT

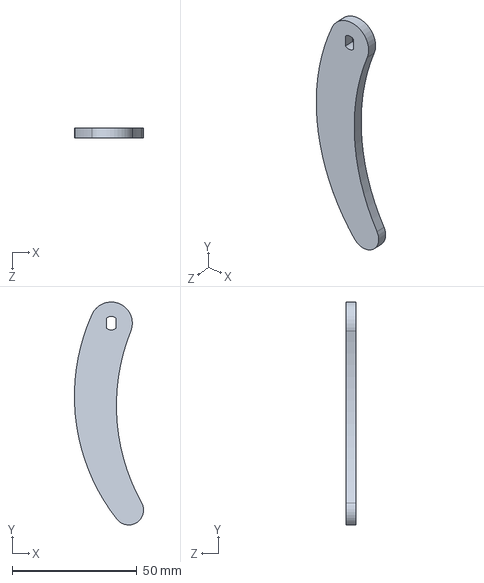
[picture p98: CAD file, 2026-06-11]
Mechanical/Shooting Mechanism/DC Arm.SLDPRT
27.7 x 89.5 x 4.00 mm
