hegazyy11/MCT231_Final_Project/Mechanical/Electric Box/Elec_Front.SLDPRT

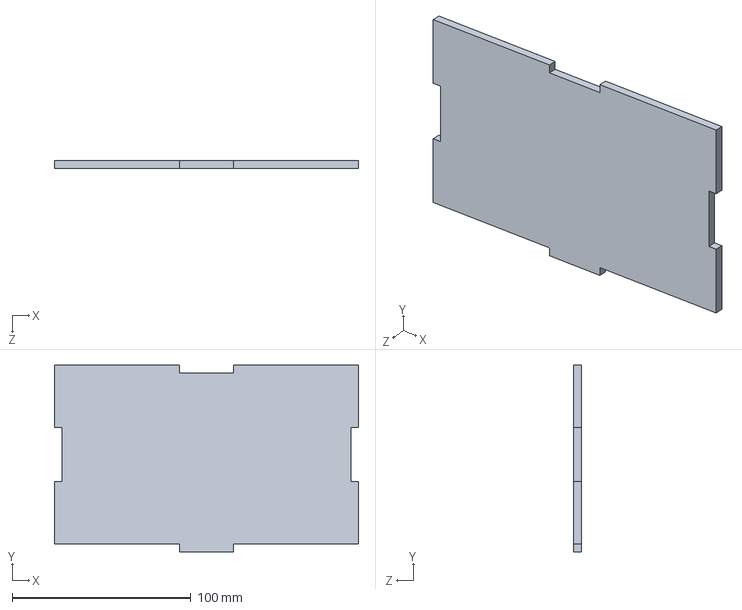
[picture p99: CAD file, 2026-06-11]
Mechanical/Electric Box/Elec_Front.SLDPRT
170.0 x 104.3 x 4.30 mm
