hegazyy11/MCT231_Final_Project/Mechanical/Routing/Sorting_To_Lifting_Slide_1.SLDPRT

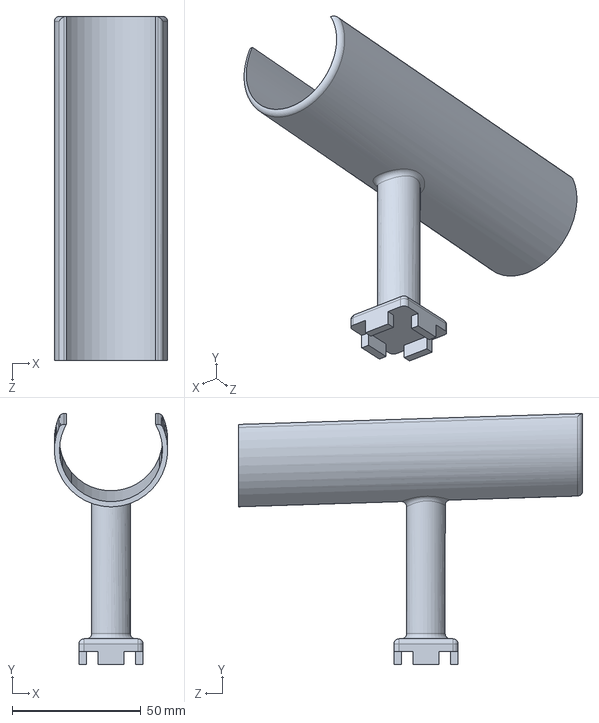
[picture p100: CAD file, 2026-06-11]
Mechanical/Routing/Sorting_To_Lifting_Slide_1.SLDPRT
44.0 x 97.5 x 133.7 mm
