hegazyy11/MCT231_Final_Project/Mechanical/Sorting Mechanism/IR Floor.SLDPRT

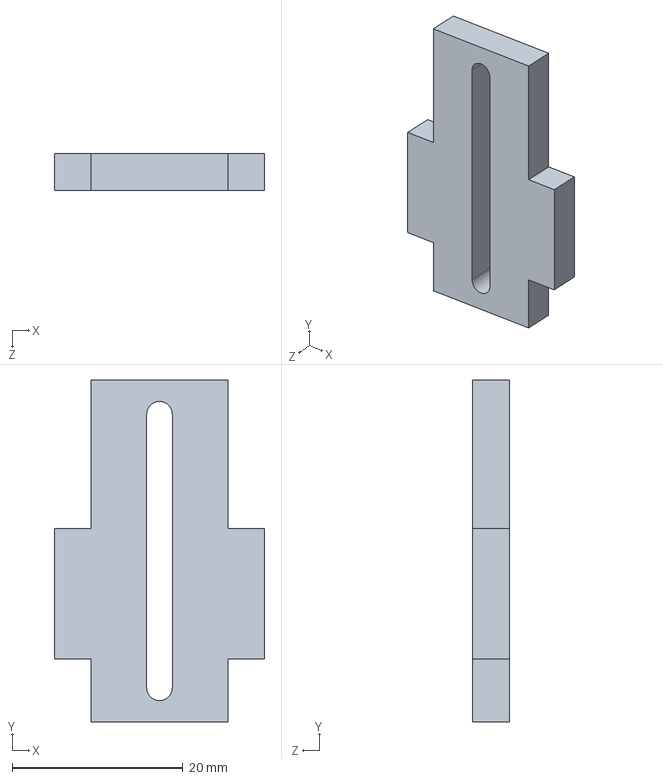
[picture p101: CAD file, 2026-06-11]
Mechanical/Sorting Mechanism/IR Floor.SLDPRT
24.6 x 40.0 x 4.30 mm
