hegazyy11/MCT231_Final_Project/Mechanical/Electric Box/Elec_Side.SLDPRT

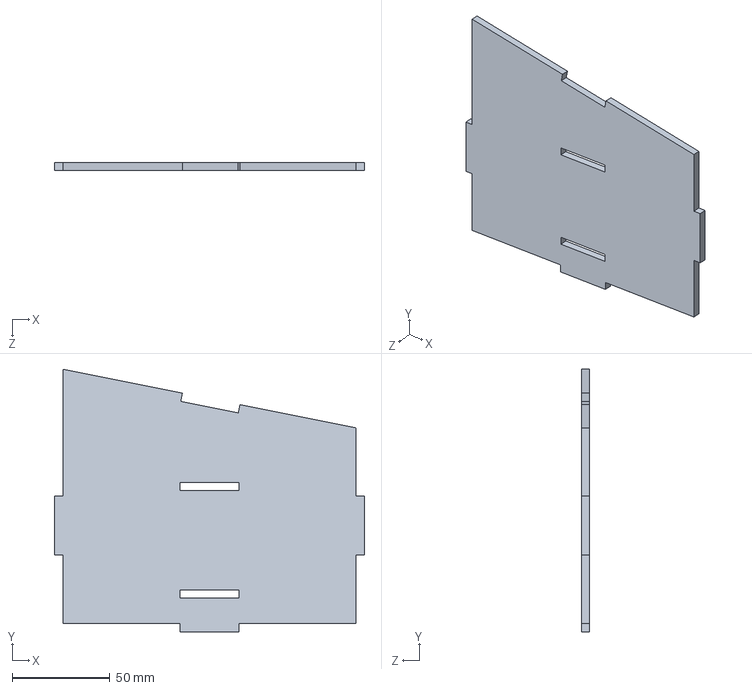
[picture p102: CAD file, 2026-06-11]
Mechanical/Electric Box/Elec_Side.SLDPRT
158.6 x 134.3 x 4.30 mm
