hegazyy11/MCT231_Final_Project/Mechanical/Shooting Mechanism/SWITCH LIMIT 30x16x10.SLDPRT

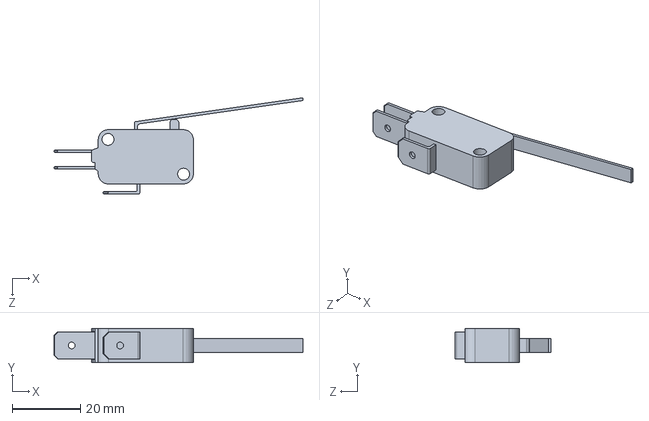
[picture p103: CAD file, 2026-06-11]
Mechanical/Shooting Mechanism/SWITCH LIMIT 30x16x10.SLDPRT
73.2 x 10.0 x 28.3 mm
