hegazyy11/MCT231_Final_Project/Mechanical/Sorting Mechanism/First Floor.SLDPRT

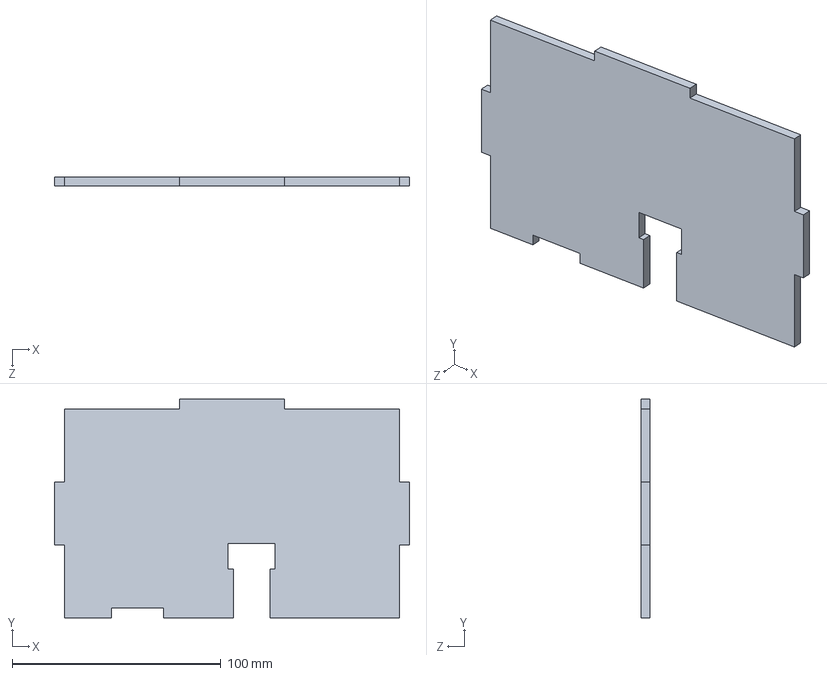
[picture p104: CAD file, 2026-06-11]
Mechanical/Sorting Mechanism/First Floor.SLDPRT
170.0 x 104.7 x 4.30 mm
