hegazyy11/MCT231_Final_Project/Mechanical/Shooting Mechanism/Ball.SLDPRT

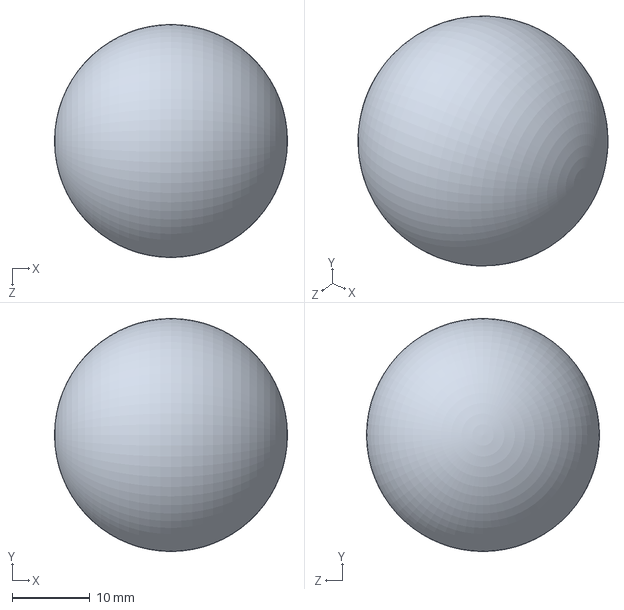
[picture p105: CAD file, 2026-06-11]
Mechanical/Shooting Mechanism/Ball.SLDPRT
30.0 x 30.0 x 30.0 mm
