hegazyy11/MCT231_Final_Project/Mechanical/Electric Box/Elec_Floor.SLDPRT

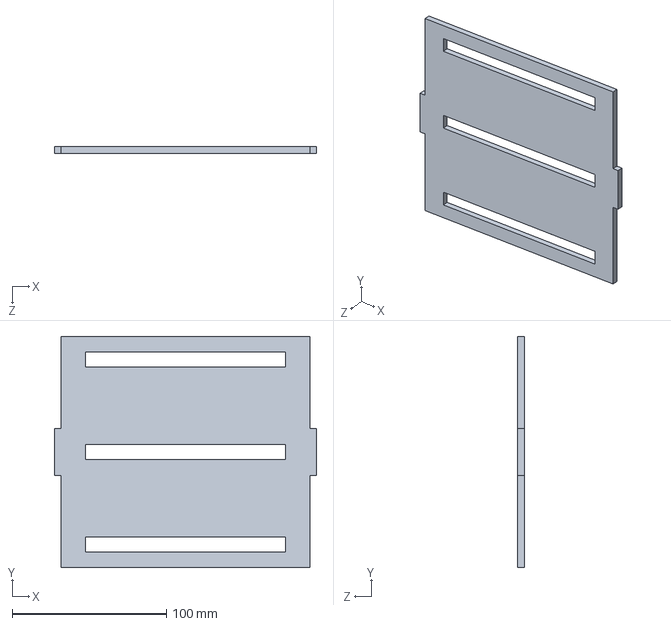
[picture p107: CAD file, 2026-06-11]
Mechanical/Electric Box/Elec_Floor.SLDPRT
170.0 x 150.0 x 4.30 mm
