hegazyy11/MCT231_Final_Project/Mechanical/Sorting Mechanism/sorting covvvver.SLDPRT

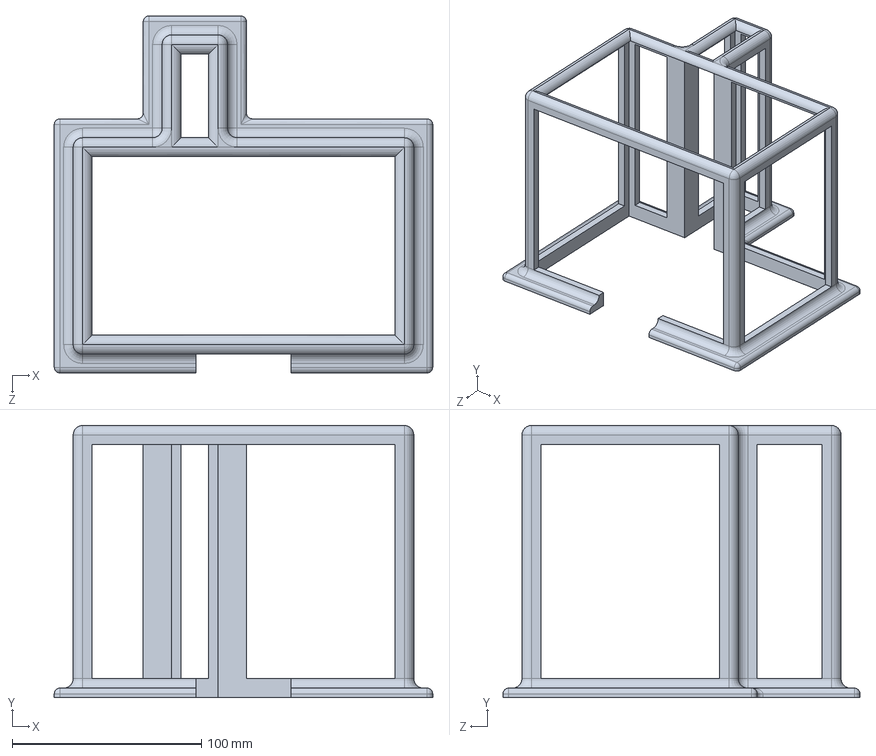
[picture p108: CAD file, 2026-06-11]
Mechanical/Sorting Mechanism/sorting covvvver.SLDPRT
200.0 x 143.8 x 188.6 mm
