hegazyy11/MCT231_Final_Project/Mechanical/Electric Box/rocker switch on off.SLDPRT

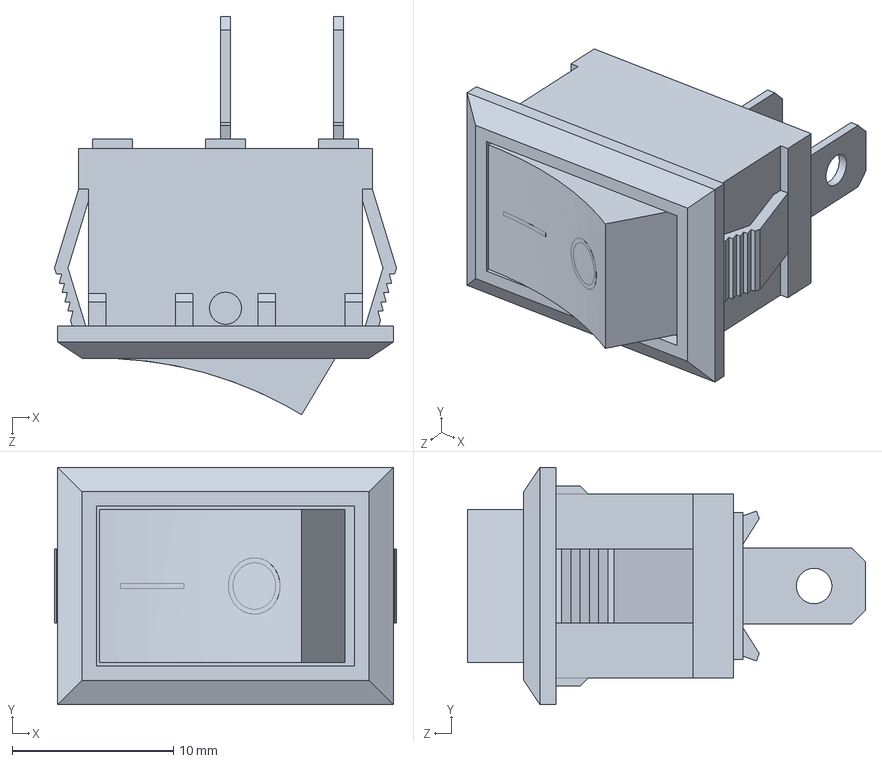
[picture p110: CAD file, 2026-06-11]
Mechanical/Electric Box/rocker switch on off.SLDPRT
21.2 x 14.7 x 24.7 mm
