hegazyy11/MCT231_Final_Project/Mechanical/Sorting Mechanism/Sorting Slide.SLDPRT

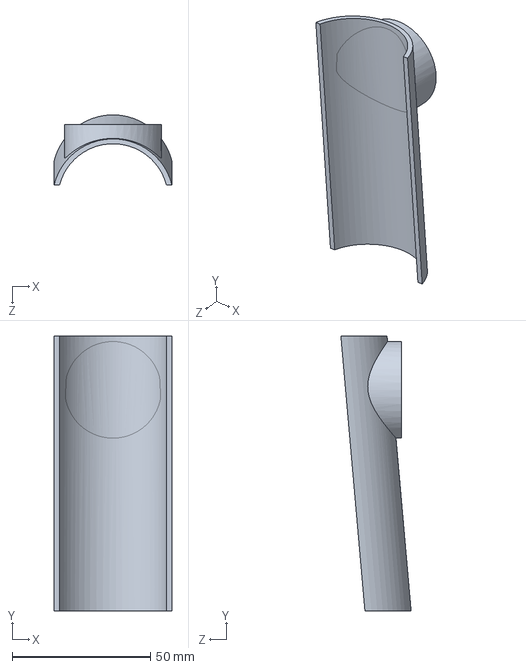
[picture p111: CAD file, 2026-06-11]
Mechanical/Sorting Mechanism/Sorting Slide.SLDPRT
42.7 x 99.6 x 25.5 mm
