hegazyy11/MCT231_Final_Project/Mechanical/Electric Box/box coverrrrrrr.SLDPRT

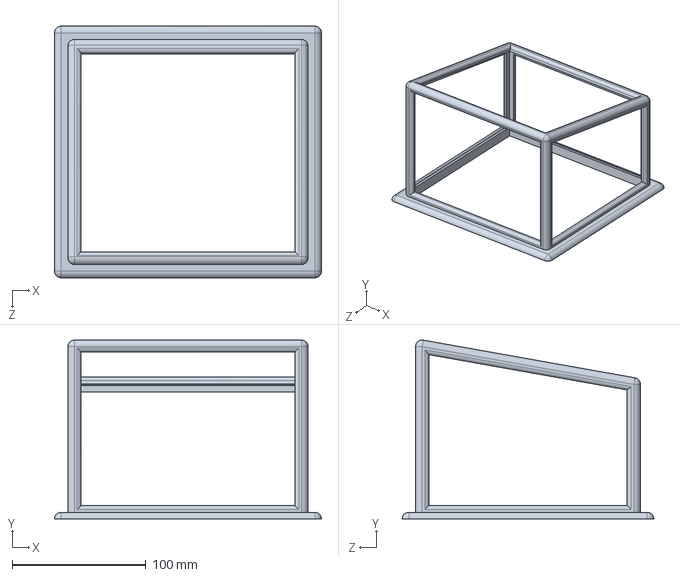
[picture p112: CAD file, 2026-06-11]
Mechanical/Electric Box/box coverrrrrrr.SLDPRT
200.0 x 134.0 x 188.6 mm
