hegazyy11/MCT231_Final_Project/Mechanical/Sorting Mechanism/IR Tower Back.SLDPRT

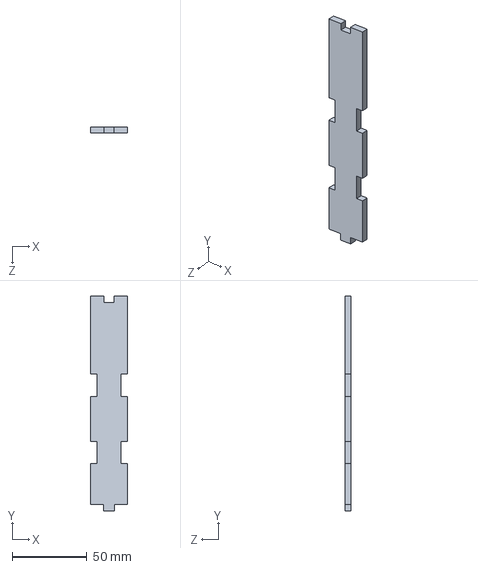
[picture p113: CAD file, 2026-06-11]
Mechanical/Sorting Mechanism/IR Tower Back.SLDPRT
24.6 x 144.3 x 4.30 mm
