hegazyy11/MCT231_Final_Project/Mechanical/Sorting Mechanism/Back Wall.SLDPRT

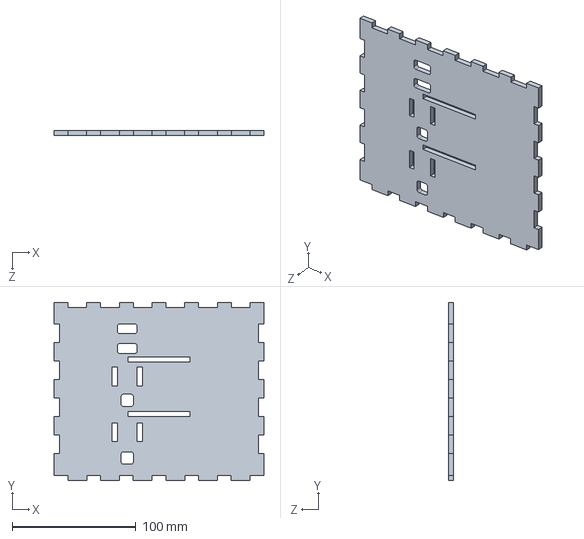
[picture p114: CAD file, 2026-06-11]
Mechanical/Sorting Mechanism/Back Wall.SLDPRT
170.0 x 144.3 x 4.30 mm
