hegazyy11/MCT231_Final_Project/Mechanical/Sorting Mechanism/[4145] TowerPro SG90 Mini Servo-SunRobotics_in-Pt3.SLDPRT

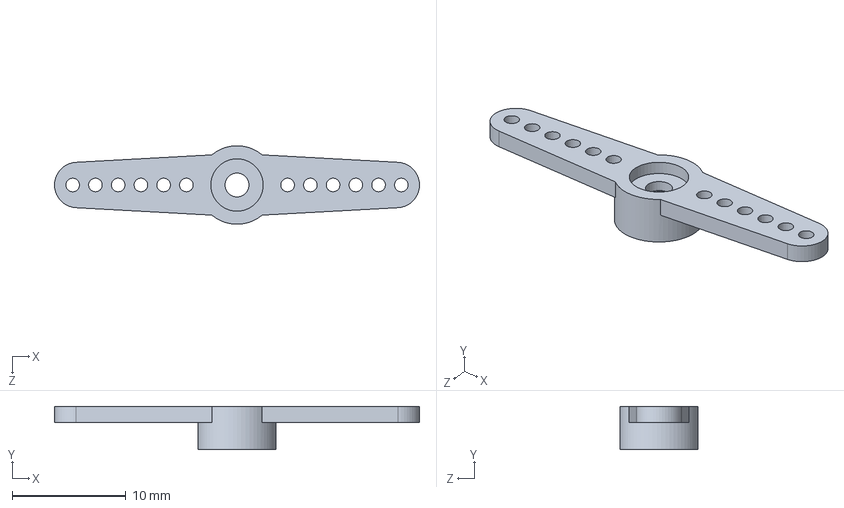
[picture p115: CAD file, 2026-06-11]
Mechanical/Sorting Mechanism/[4145] TowerPro SG90 Mini Servo-SunRobotics_in-Pt3.SLDPRT
32.1 x 3.80 x 6.90 mm
