hegazyy11/MCT231_Final_Project/Mechanical/Sorting Mechanism/IR Tower Seiling.SLDPRT

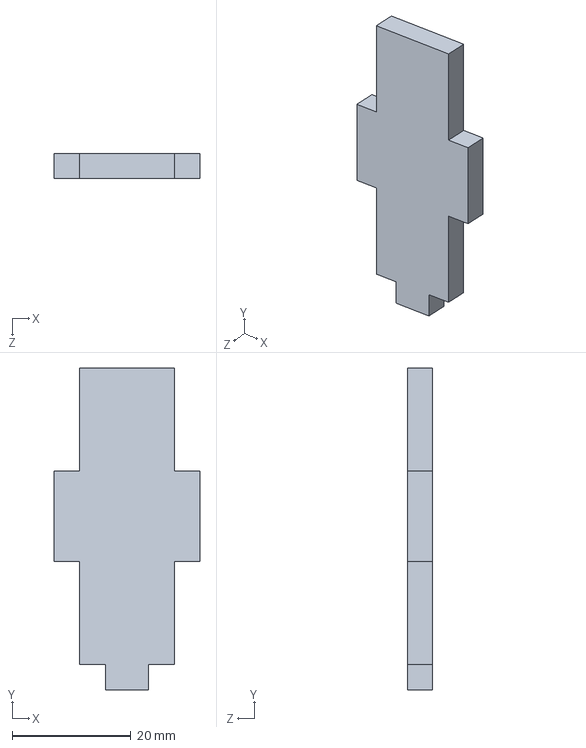
[picture p116: CAD file, 2026-06-11]
Mechanical/Sorting Mechanism/IR Tower Seiling.SLDPRT
24.6 x 54.3 x 4.30 mm
