hegazyy11/MCT231_Final_Project/(list of files, cad)

Other CAD files:
Mechanical/Shooting Mechanism/IRsensors.SLDASM
Mechanical/Electric Box/ic184-thread.SLDPRT
Mechanical/Electric Box/ic184-thread_red.SLDPRT
Mechanical/Sorting Mechanism/Right Wall.SLDPRT
Mechanical/Electric Box/ic184-thread_black.SLDPRT
Mechanical/Sorting Mechanism/Seiling.SLDPRT
