hegazyy11/MCT231_Final_Project/Docs/AMONG US FINAL_A0_Poster.pdf

# AMONG US

# AN AUTOMATED CLOSED-LOOP SORTING, SHOOTING & LIFTING TOY

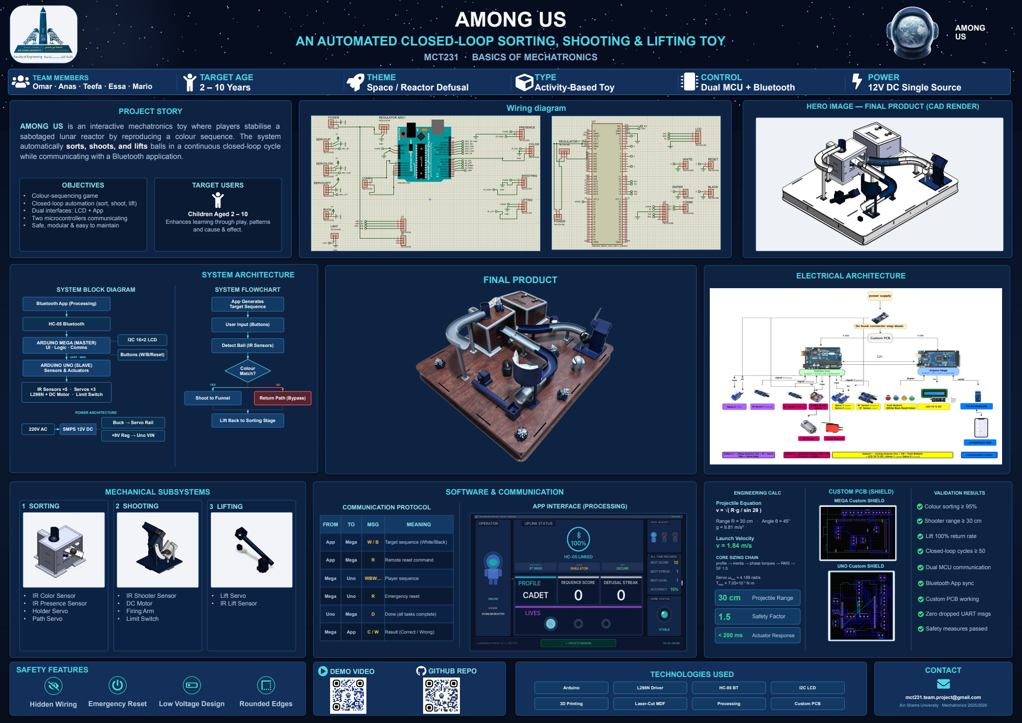
[picture p117: page 1]
AMONG US; TARGET AGE 2 – 10 Years; PROJECT STORY; OBJECTIVES; TARGET USERS; Children Aged 2 – 10; Wiring diagram; HERO IMAGE — FINAL PRODUCT (CAD RENDER); SYSTEM ARCHITECTURE; HC-05 Bluetooth; UART · 9600; I2C 16×2 LCD; Buttons (W/B/Reset); POWER ARCHITECTURE; SMPS 12V DC; SYSTEM FLOWCHART; App Generates Target Sequence; Colour Match?; Shoot to Funnel; Return Path (Bypass); YES; ELECTRICAL ARCHITECTURE; MECHANICAL SUBSYSTEMS; 1 SORTING; 2 SHOOTING; 3 LIFTING; SOFTWARE & COMMUNICATION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

MCT231 · BASICS OF MECHATRONICS

THEME
Space / Reactor Defusal

TYPE
Activity-Based Toy

CONTROL
Dual MCU + Bluetooth

POWER
12V DC Single Source

TEAM MEMBERS
Omar · Anas · Teefa · Essa · Mario

AMONG US is an interactive mechatronics toy where players stabilise a
sabotaged lunar reactor by reproducing a colour sequence. The system
automatically sorts, shoots, and lifts balls in a continuous closed-loop cycle
while communicating with a Bluetooth application.

• Colour-sequencing game
• Closed-loop automation (sort, shoot, lift)
• Dual interfaces: LCD + App
• Two microcontrollers communicating
• Safe, modular & easy to maintain

Enhances learning through play, patterns

and cause & effect.

SYSTEM BLOCK DIAGRAM

Bluetooth App (Processing)

User Input (Buttons)

ARDUINO MEGA (MASTER)
UI · Logic · Comms

Detect Ball (IR Sensors)

ARDUINO UNO (SLAVE)
Sensors & Actuators

IR Sensors ×5 · Servos ×3
L298N + DC Motor · Limit Switch

Lift Back to Sorting Stage

Buck → Servo Rail

+9V Reg → Uno VIN

CUSTOM PCB (SHIELD)

MEGA Custom SHIELD

APP INTERFACE (PROCESSING)

Range R = 30 cm · Angle θ = 45°

Shooter range ≥ 30 cm

FROM | TO | MSG | MEANING

Lift 100% return rate

App | Mega | W / B | | Target sequence (White/Black)

Closed-loop cycles ≥ 50

CORE SIZING CHAIN
profile → inertia → phase torques → RMS →

App | Mega | R | | Remote reset command

UNO Custom SHIELD

Dual MCU communication

Mega | Uno | WBW… | | Player sequence

Bluetooth App sync

• IR Color Sensor
• IR Presence Sensor
• Holder Servo
• Path Servo

• IR Shooter Sensor
• DC Motor
• Firing Arm
• Limit Switch

• Lift Servo
• IR Lift Sensor

Mega | Uno | R | | Emergency reset

Custom PCB working

Uno | Mega | D | | Done (all tasks complete)

Zero dropped UART msgs

Safety measures passed

Mega | App | C / W | | Result (Correct / Wrong)

mct231.team.project@gmail.com

Ain Shams University · Mechatronics 2025/2026
