hegazyy11/MCT231_Final_Project/Electrical/block diagram.pdf

## power supply

## Dc buck converter step down

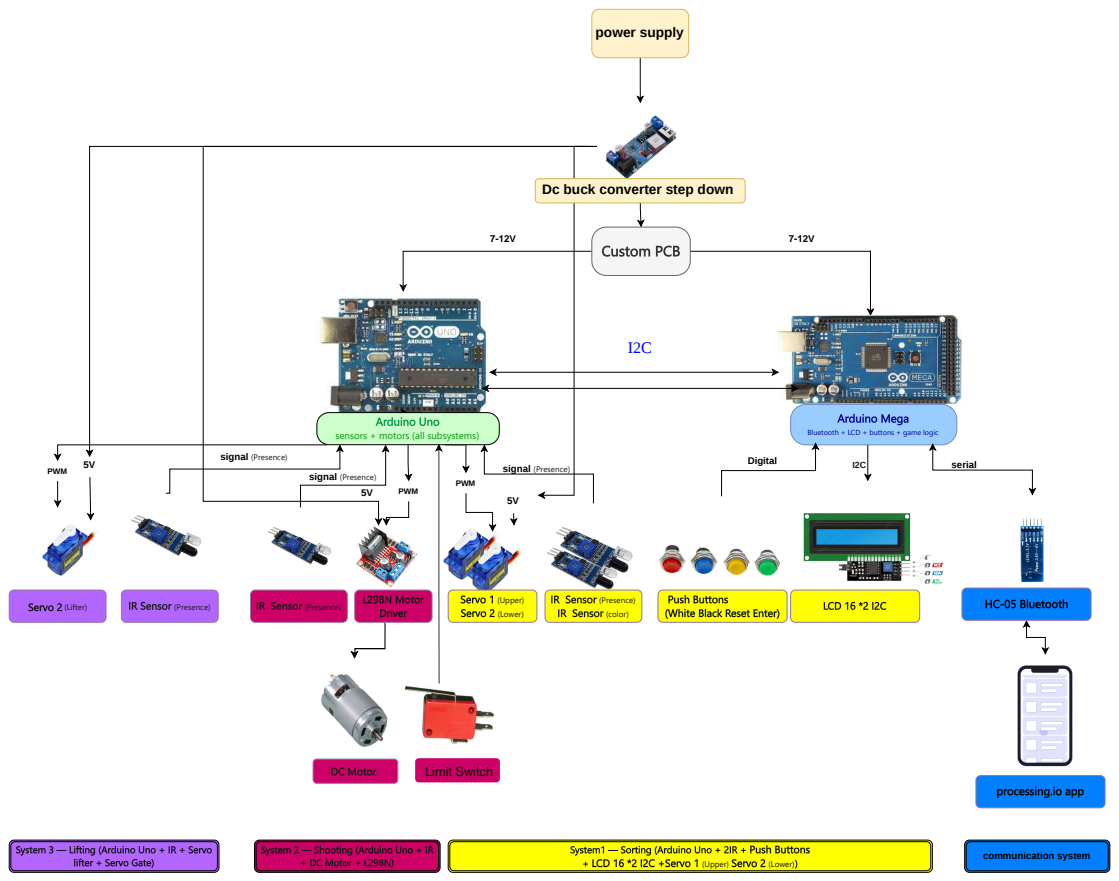
[picture p118: page 1]
Custom PCB; Arduino Mega; Arduino Uno; (Lifter); IR Sensor (Presence); signal (Presence); L298N Motor Driver; DC Motor; PWM; + DC Motor + L298N); Servo 1 (Upper) Servo 2 (Lower); LCD 16 *2 I2C; Digital; serial; HC-05 Bluetooth; communication system; Limit Switch

sensors + motors (all subsystems)

Bluetooth + LCD + buttons + game logic

IR Sensor (Presence)
IR Sensor (color)

Push Buttons
(White Black Reset Enter)

processing.io app

System 3 — Lifting (Arduino Uno + IR + Servo

System 2 — Shooting (Arduino Uno + IR

System1 — Sorting (Arduino Uno + 2IR + Push Buttons
+ LCD 16 *2 I2C +Servo 1 (Upper) Servo 2 (Lower))

lifter + Servo Gate)
