hegazyy11/MCT231_Final_Project/(list of files, drawings)

Other design files:
Electrical/PCB & Wiring Diagram/megafinal.pdsprj
Electrical/PCB & Wiring Diagram/UNOfinal.pdsprj
